MH-Flight-Simulator-X/PCB/Images/MicroHard.bmp

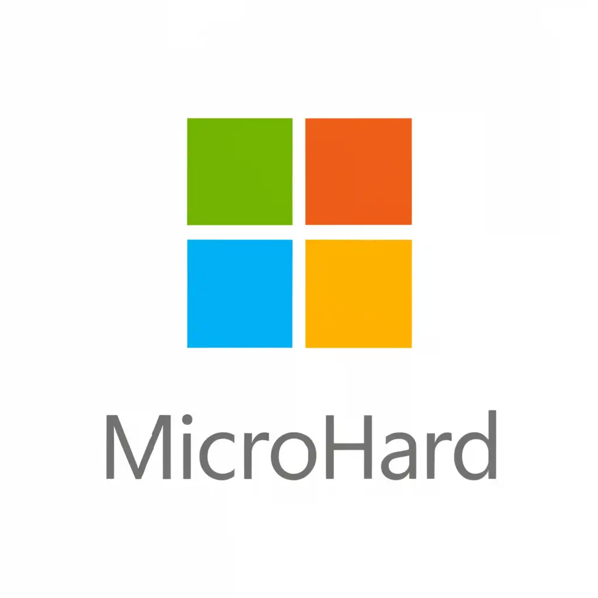
Images/MicroHard.bmp
