MH-Flight-Simulator-X/PCB/partsLib/CB3_3C_20M000000/CB3-3C-20M000000.step

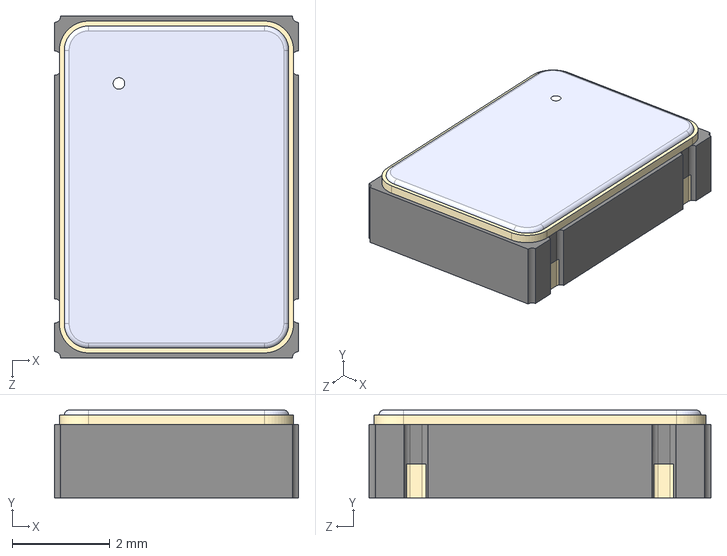
[picture p2: CAD file, 2024-09-24]
partsLib/CB3_3C_20M000000/CB3-3C-20M000000.step
5.00 x 1.80 x 7.00 mm
