MH-Flight-Simulator-X/PCB/partsLib/L77HDE15SD1CH4FVGA/L77HDE15SD1CH4FVGA.step

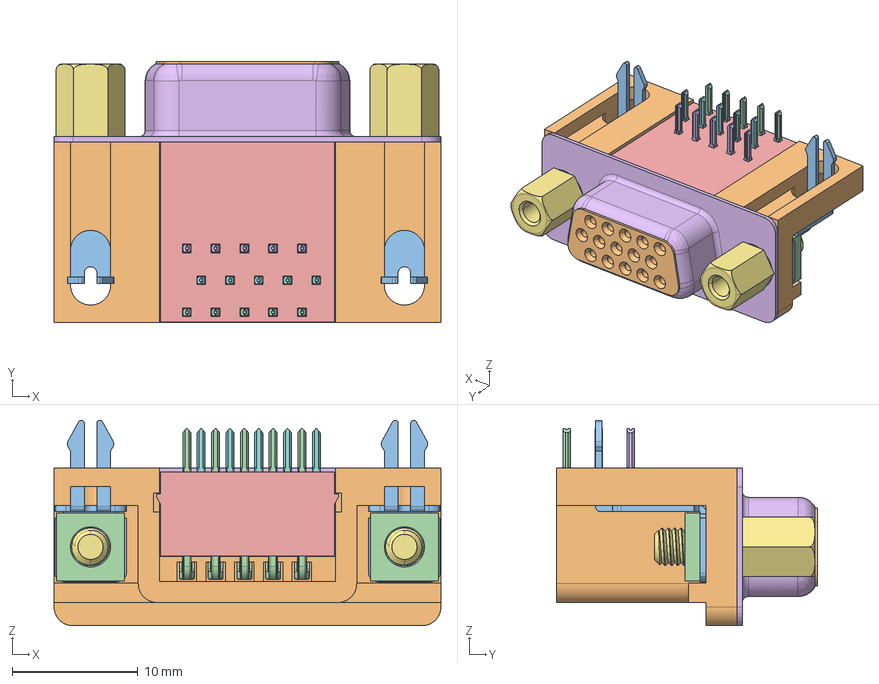
[picture p3: CAD file, 2024-09-26]
partsLib/L77HDE15SD1CH4FVGA/L77HDE15SD1CH4FVGA.step
30.8 x 20.8 x 16.4 mm
D112-H15S_79
ZZ_11 x 2
MM_3 x 2
MANIFOLD_SOLID_BREP_13339 x 5
MANIFOLD_SOLID_BREP_16179 x 5
MANIFOLD_SOLID_BREP_18054
MANIFOLD_SOLID_BREP_20824
MANIFOLD_SOLID_BREP_22635
MANIFOLD_SOLID_BREP_25405
MANIFOLD_SOLID_BREP_27216
MANIFOLD_SOLID_BREP_29986
MANIFOLD_SOLID_BREP_31797
MANIFOLD_SOLID_BREP_34567
MANIFOLD_SOLID_BREP_37337
MANIFOLD_SOLID_BREP_39100
MANIFOLD_SOLID_BREP_40938 x 5
MANIFOLD_SOLID_BREP_43779 x 5
CC_25
H15S-SHEL_1
MM-2_1 x 2
