MH-Flight-Simulator-X/PCB/partsLib/XC7A100T-2FTG256C/3D/XC7A100T-2FTG256C.stp

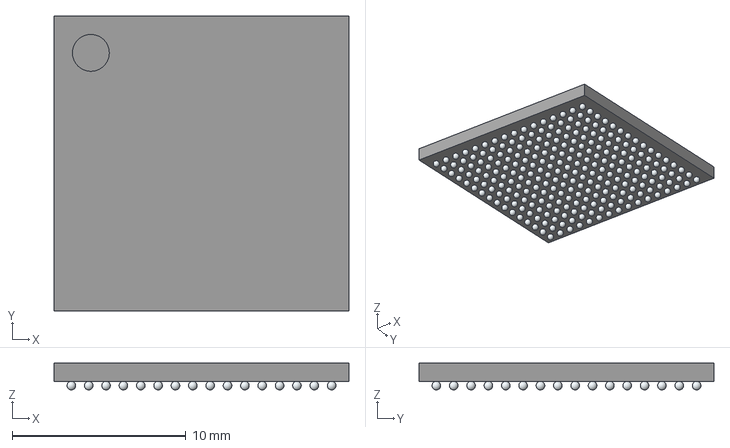
[picture p4: CAD file, 2024-09-26]
partsLib/XC7A100T-2FTG256C/3D/XC7A100T-2FTG256C.stp
17.0 x 17.0 x 1.55 mm
