MH-Flight-Simulator-X/PCB/partsLib/0878321420/87832-1420.step

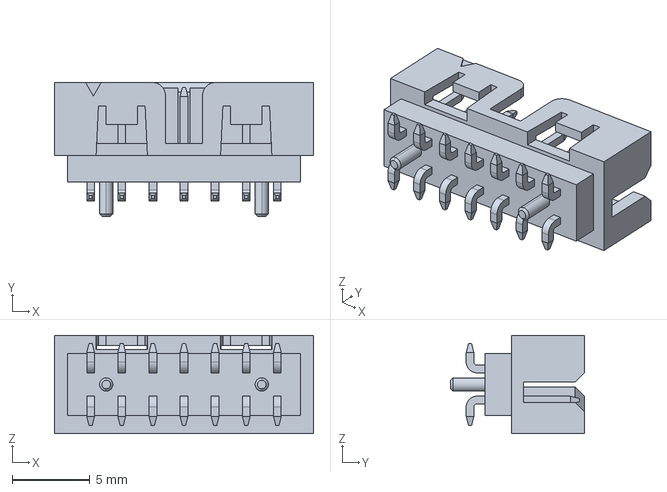
[picture p5: CAD file, 2024-09-26]
partsLib/0878321420/87832-1420.step
16.6 x 8.60 x 6.30 mm
