MH-Flight-Simulator-X/PCB/(list of files, cad)

Other CAD files:
MicroHardController/joystick_based.scad
MicroHardController/original.scad
partsLib/XC7A100T-2FTG256C/Allegro/bga256c100p16x16_1700x1700x155.psm
partsLib/XC7A100T-2FTG256C/DEHDL/xc7a100t_2ftg256c/chips/chips.prt
