MH-Flight-Simulator-X/PCB/(list of files, drawings)

Other design files:
partsLib/XC7A100T-2FTG256C/Altium/BGA256C100P16X16_1700X1700X155.PcbLib
partsLib/XC7A100T-2FTG256C/Altium/XC7A100T-2FTG256C.SchLib
