MH-Flight-Simulator-X/PCB/MicroHard/MicroHard.kicad_pcb

## KiCad design MicroHard/MicroHard.kicad_pcb (2024-11-20)

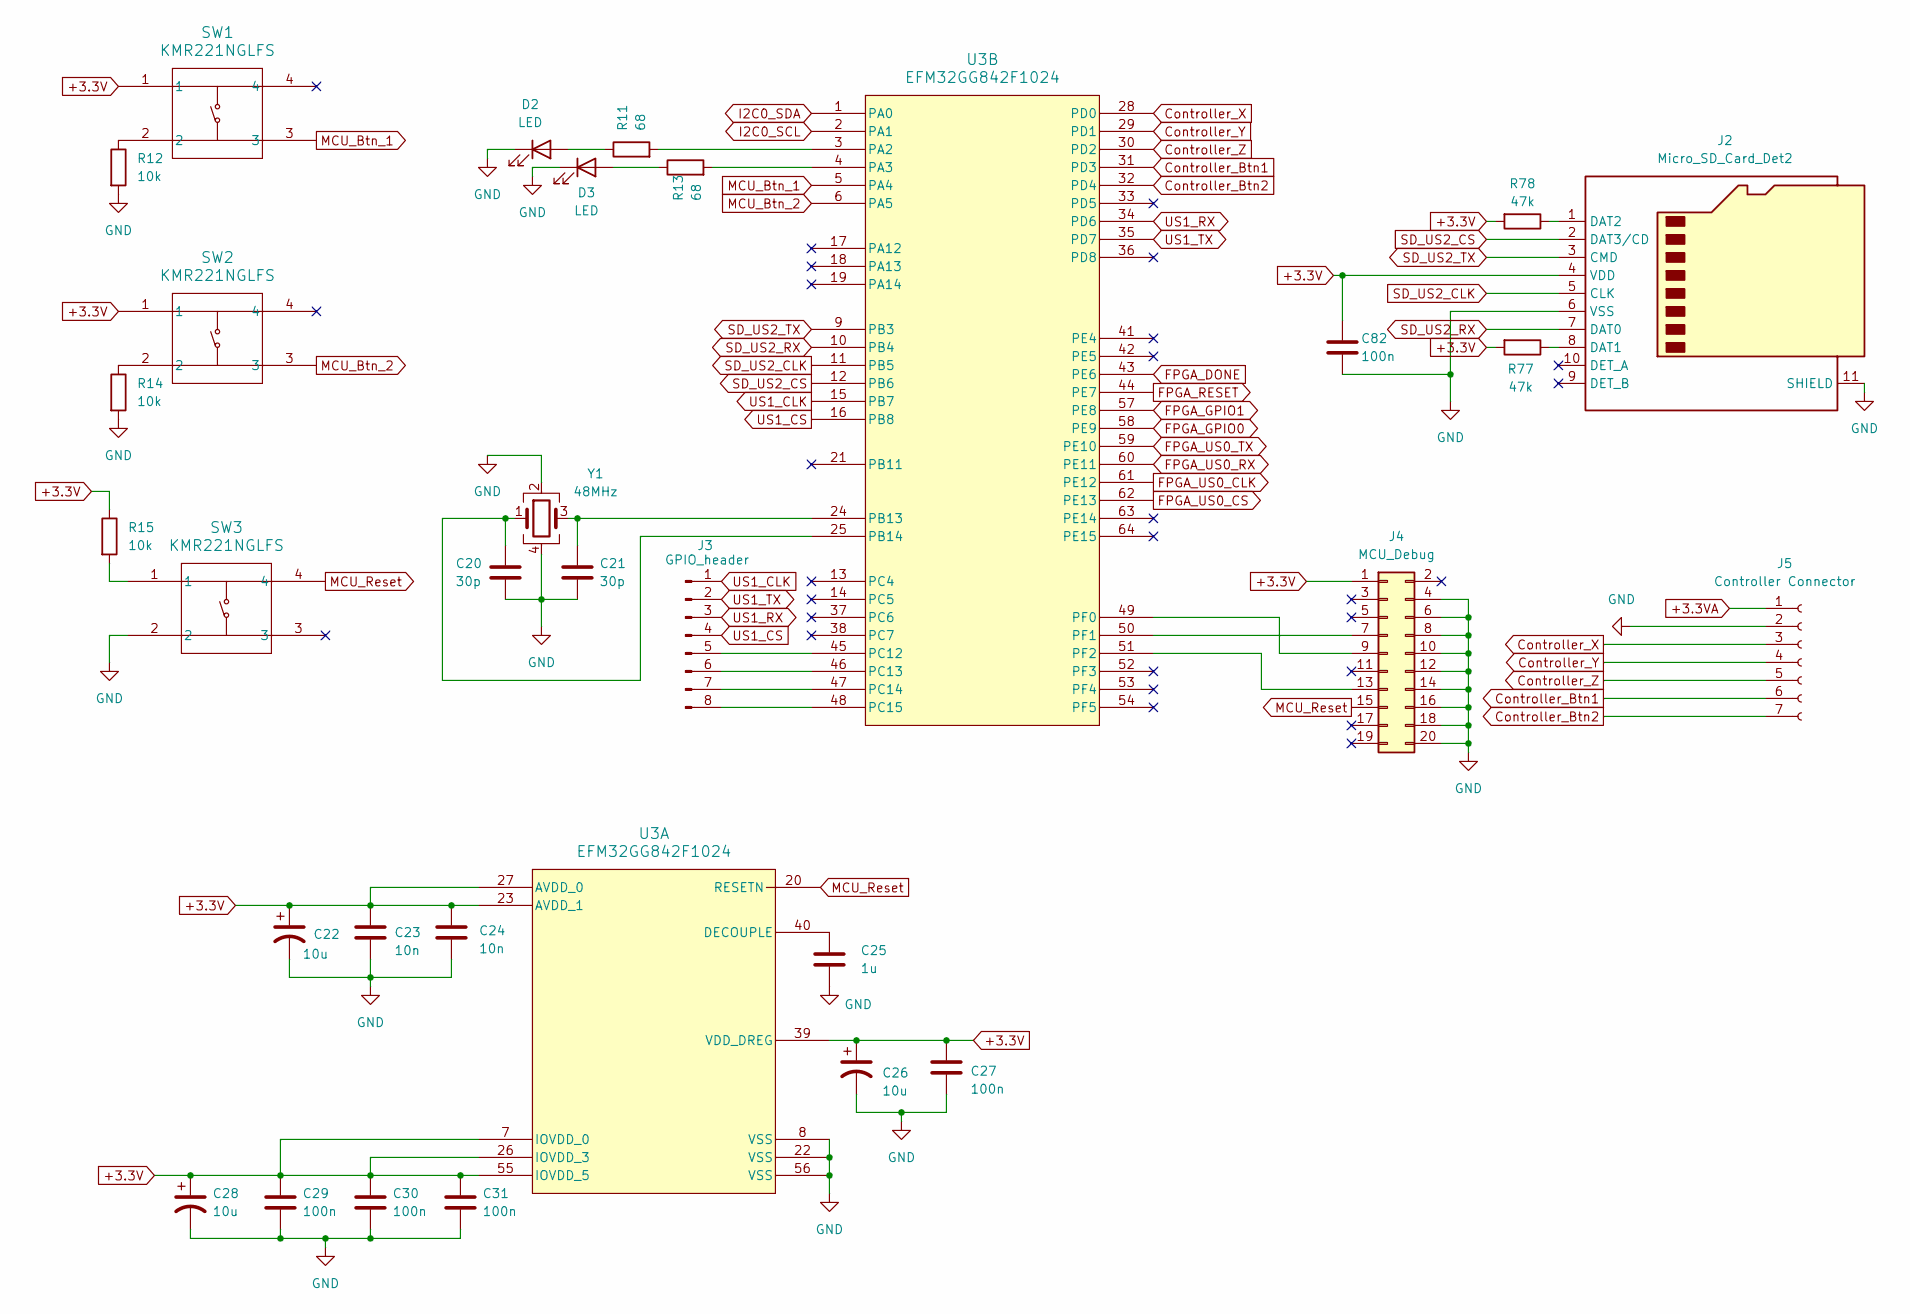
[picture p6: schematic mcu.kicad_sch, Microcontroller unit (MCU)]

Parts:
C20, C21: 30p; C_0805_2012Metric_Pad1.18x1.45mm_HandSolder
C22, C26, C28: 10u; C_1206_3216Metric_Pad1.33x1.80mm_HandSolder
C23, C24: 10n; C_1206_3216Metric_Pad1.33x1.80mm_HandSolder
C25: 1u; C_1206_3216Metric_Pad1.33x1.80mm_HandSolder
C27, C29, C30, C31, C82: 100n; C_1206_3216Metric_Pad1.33x1.80mm_HandSolder
D2, D3: LED; LED_1206_3216Metric_Pad1.42x1.75mm_HandSolder
J2: Micro_SD_Card_Det2; microSD_HC_Hirose_DM3AT-SF-PEJM5
J3: GPIO_header; PinHeader_1x08_P2.54mm_Vertical
J4: MCU_Debug; IDC-Header_2x10_P2.54mm_Vertical
J5: Controller Connector; PinHeader_1x07_P2.54mm_Vertical
R11, R13: 68; R_1206_3216Metric_Pad1.30x1.75mm_HandSolder
R12, R14, R15: 10k; R_1206_3216Metric_Pad1.30x1.75mm_HandSolder
R77, R78: 47k; R_1206_3216Metric_Pad1.30x1.75mm_HandSolder
SW1, SW2, SW3: KMR221NGLFS; KMR221_CNK
U3: EFM32GG842F1024; QFP64_10X10
Y1: 48MHz; Crystal_SMD_3225-4Pin_3.2x2.5mm_HandSoldering

Connections:
+3.3V: C22.1, C23.1, C24.1, C26.1, C27.1, C28.1, C29.1, C30.1, C31.1, C82.1, J2.4 (VDD), J4.1, R15.1, R77.2, R78.2, SW1.1, SW2.1, U3.7 (IOVDD_0), U3.23 (AVDD_1), U3.26 (IOVDD_3), U3.27 (AVDD_0), U3.39 (VDD_DREG), U3.55 (IOVDD_5); also elsewhere on the board
+3.3VA: J5.1; also elsewhere on the board
Controller_Btn1: J5.6, U3.31 (PD3)
Controller_Btn2: J5.7, U3.32 (PD4)
Controller_X: J5.3, U3.28 (PD0)
Controller_Y: J5.4, U3.29 (PD1)
Controller_Z: J5.5, U3.30 (PD2)
FPGA_DONE: U3.43 (PE6); also elsewhere on the board
FPGA_GPIO0: U3.58 (PE9); also elsewhere on the board
FPGA_GPIO1: U3.57 (PE8); also elsewhere on the board
FPGA_RESET: U3.44 (PE7); also elsewhere on the board
FPGA_US0_CLK: U3.61 (PE12); also elsewhere on the board
FPGA_US0_CS: U3.62 (PE13); also elsewhere on the board
FPGA_US0_RX: U3.60 (PE11); also elsewhere on the board
FPGA_US0_TX: U3.59 (PE10); also elsewhere on the board
GND: C20.2, C21.2, C22.2, C23.2, C24.2, C25.2, C26.2, C27.2, C28.2, C29.2, C30.2, C31.2, C82.2, D2.1 (K), D3.1 (K), J2.6 (VSS), J2.11 (SHIELD), J4.4, J4.6, J4.8, J4.10, J4.12, J4.14, J4.16, J4.18, J4.20, J5.2, R12.2, R14.2, SW3.2, U3.8 (VSS), U3.22 (VSS), U3.56 (VSS), Y1.2, Y1.4; also elsewhere on the board
I2C0_SCL: U3.2 (PA1); also elsewhere on the board
I2C0_SDA: U3.1 (PA0); also elsewhere on the board
MCU_Btn_1: SW1.3, U3.5 (PA4)
MCU_Btn_2: SW2.3, U3.6 (PA5)
MCU_Reset: J4.15, SW3.4, U3.20 (RESETN)
unnamed: D2.2 (A), R11.1
unnamed: D3.2 (A), R13.1
unnamed: J2.8 (DAT1), R77.1
unnamed: J2.1 (DAT2), R78.1
unnamed: J3.5, U3.45 (PC12)
unnamed: J3.6, U3.46 (PC13)
unnamed: J3.7, U3.47 (PC14)
unnamed: J3.8, U3.48 (PC15)
unnamed: J4.7, U3.50 (PF1)
unnamed: J4.9, U3.49 (PF0)
unnamed: J4.13, U3.51 (PF2)
unnamed: R12.1, SW1.2
unnamed: R14.1, SW2.2
unnamed: R15.2, SW3.1
unnamed: C25.1, U3.40 (DECOUPLE)
unnamed: R11.2, U3.3 (PA2)
unnamed: R13.2, U3.4 (PA3)
unnamed: C21.1, U3.24 (PB13), Y1.3
unnamed: C20.1, U3.25 (PB14), Y1.1
SD_US2_CLK: J2.5 (CLK), U3.11 (PB5)
SD_US2_CS: J2.2 (DAT3/CD), U3.12 (PB6)
SD_US2_RX: J2.7 (DAT0), U3.10 (PB4)
SD_US2_TX: J2.3 (CMD), U3.9 (PB3)
US1_CLK: J3.1, U3.15 (PB7)
US1_CS: J3.4, U3.16 (PB8)
US1_RX: J3.3, U3.34 (PD6)
US1_TX: J3.2, U3.35 (PD7)

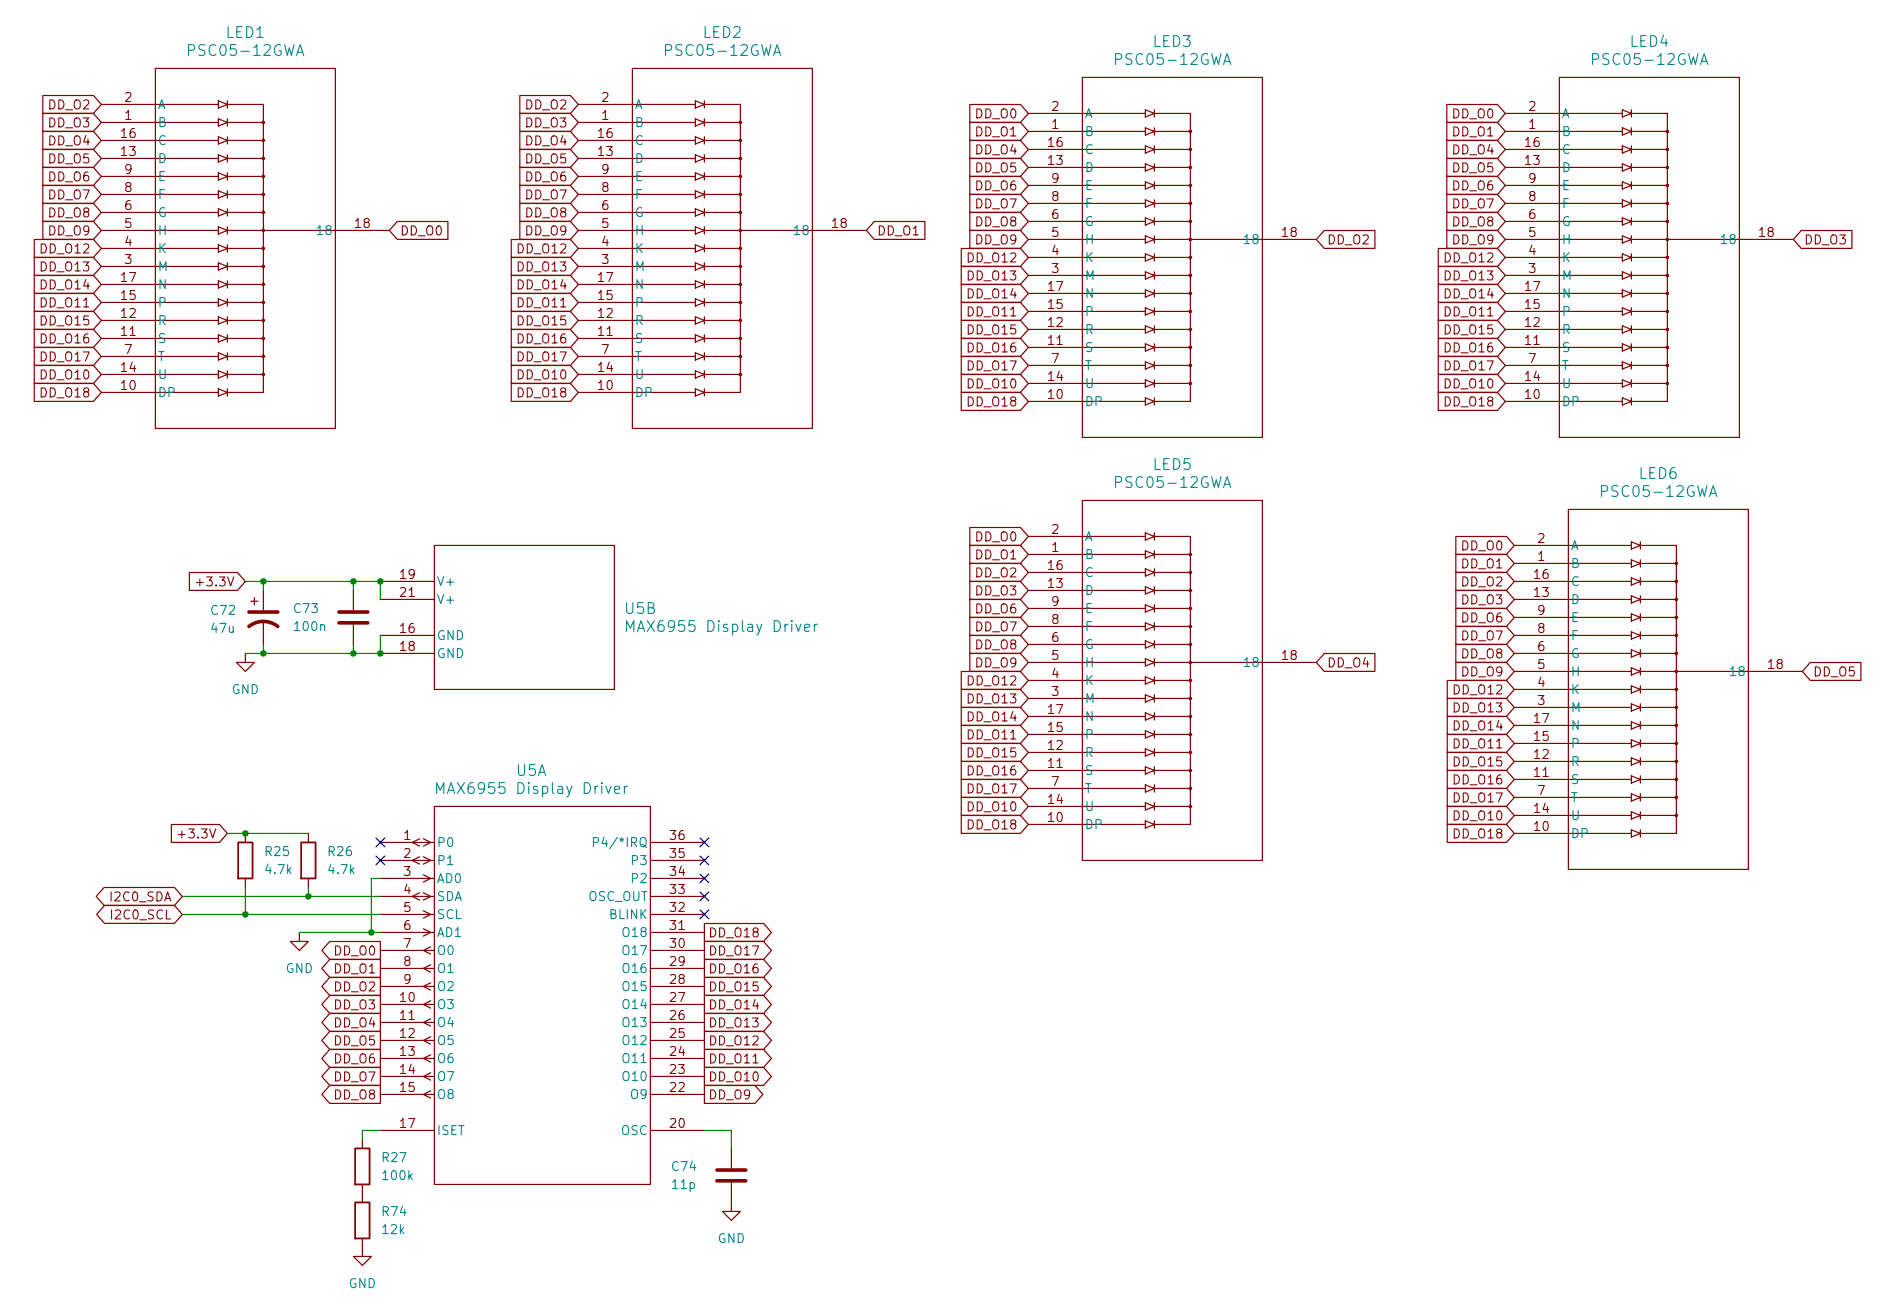
[picture p7: schematic display.kicad_sch, Alphanumeric Display]

Parts:
C72: 47u; C_1210_3225Metric_Pad1.33x2.70mm_HandSolder
C73: 100n; C_1206_3216Metric_Pad1.33x1.80mm_HandSolder
C74: 11p; C_0805_2012Metric_Pad1.18x1.45mm_HandSolder
LED1, LED2, LED3, LED4, LED5, LED6: PSC05-12GWA; PSC05-12GWA_LTO
R25, R26: 4.7k; R_1206_3216Metric_Pad1.30x1.75mm_HandSolder
R27: 100k; R_1206_3216Metric_Pad1.30x1.75mm_HandSolder
R74: 12k; R_1206_3216Metric_Pad1.30x1.75mm_HandSolder
U5: MAX6955 Display Driver; 21-0040_A36&plus_2_MXM

Connections:
+3.3V: C72.1, C73.1, R25.1, R26.1, U5.19 (V+), U5.21 (V+); also elsewhere on the board
DD_O0: LED1.18, LED3.2 (A), LED4.2 (A), LED5.2 (A), LED6.2 (A), U5.7 (O0)
DD_O1: LED2.18, LED3.1 (B), LED4.1 (B), LED5.1 (B), LED6.1 (B), U5.8 (O1)
DD_O2: LED1.2 (A), LED2.2 (A), LED3.18, LED5.16 (C), LED6.16 (C), U5.9 (O2)
DD_O3: LED1.1 (B), LED2.1 (B), LED4.18, LED5.13 (D), LED6.13 (D), U5.10 (O3)
DD_O4: LED1.16 (C), LED2.16 (C), LED3.16 (C), LED4.16 (C), LED5.18, U5.11 (O4)
DD_O5: LED1.13 (D), LED2.13 (D), LED3.13 (D), LED4.13 (D), LED6.18, U5.12 (O5)
DD_O6: LED1.9 (E), LED2.9 (E), LED3.9 (E), LED4.9 (E), LED5.9 (E), LED6.9 (E), U5.13 (O6)
DD_O7: LED1.8 (F), LED2.8 (F), LED3.8 (F), LED4.8 (F), LED5.8 (F), LED6.8 (F), U5.14 (O7)
DD_O8: LED1.6 (G), LED2.6 (G), LED3.6 (G), LED4.6 (G), LED5.6 (G), LED6.6 (G), U5.15 (O8)
DD_O9: LED1.5 (H), LED2.5 (H), LED3.5 (H), LED4.5 (H), LED5.5 (H), LED6.5 (H), U5.22 (O9)
DD_O10: LED1.14 (U), LED2.14 (U), LED3.14 (U), LED4.14 (U), LED5.14 (U), LED6.14 (U), U5.23 (O10)
DD_O11: LED1.15, LED2.15, LED3.15, LED4.15, LED5.15, LED6.15, U5.24 (O11)
DD_O12: LED1.4 (K), LED2.4 (K), LED3.4 (K), LED4.4 (K), LED5.4 (K), LED6.4 (K), U5.25 (O12)
DD_O13: LED1.3 (M), LED2.3 (M), LED3.3 (M), LED4.3 (M), LED5.3 (M), LED6.3 (M), U5.26 (O13)
DD_O14: LED1.17 (N), LED2.17 (N), LED3.17 (N), LED4.17 (N), LED5.17 (N), LED6.17 (N), U5.27 (O14)
DD_O15: LED1.12 (R), LED2.12 (R), LED3.12 (R), LED4.12 (R), LED5.12 (R), LED6.12 (R), U5.28 (O15)
DD_O16: LED1.11 (S), LED2.11 (S), LED3.11 (S), LED4.11 (S), LED5.11 (S), LED6.11 (S), U5.29 (O16)
DD_O17: LED1.7 (T), LED2.7 (T), LED3.7 (T), LED4.7 (T), LED5.7 (T), LED6.7 (T), U5.30 (O17)
DD_O18: LED1.10 (DP), LED2.10 (DP), LED3.10 (DP), LED4.10 (DP), LED5.10 (DP), LED6.10 (DP), U5.31 (O18)
GND: C72.2, C73.2, C74.2, R74.2, U5.3 (AD0), U5.6 (AD1), U5.16 (GND), U5.18 (GND); also elsewhere on the board
I2C0_SCL: R25.2, U5.5 (SCL); also elsewhere on the board
I2C0_SDA: R26.2, U5.4 (SDA); also elsewhere on the board
unnamed: R27.2, R74.1
unnamed: R27.1, U5.17 (ISET)
unnamed: C74.1, U5.20 (OSC)

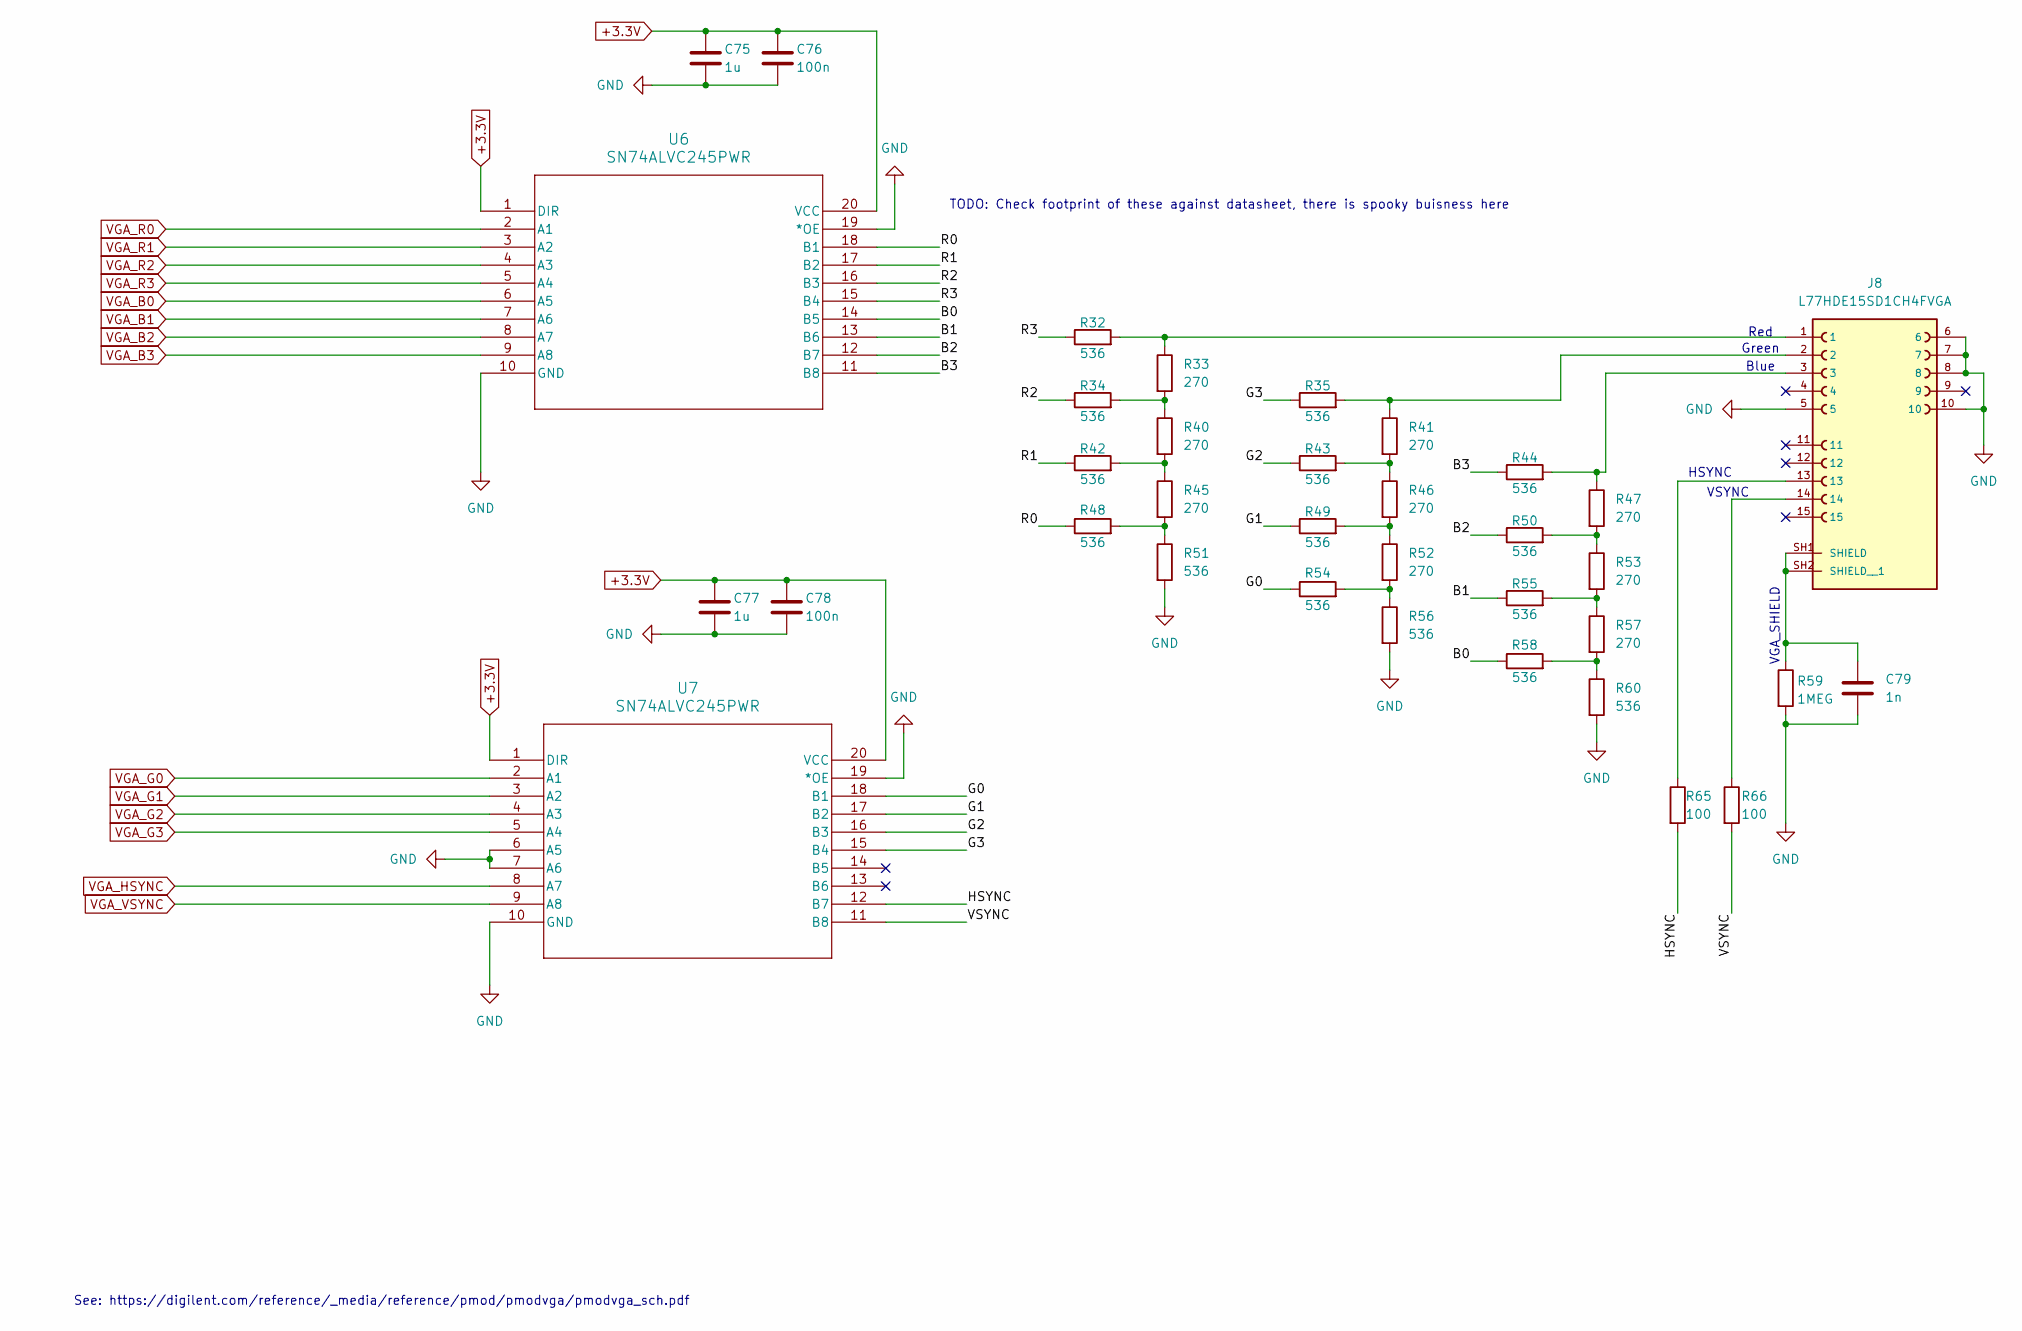
[picture p8: schematic vga_out_sch.kicad_sch, VGA]

Parts:
C75, C77: 1u; C_1206_3216Metric_Pad1.33x1.80mm_HandSolder
C76, C78: 100n; C_1206_3216Metric_Pad1.33x1.80mm_HandSolder
C79: 1n; C_0805_2012Metric_Pad1.18x1.45mm_HandSolder
J8: L77HDE15SD1CH4FVGA; AMPHENOL_L77HDE15SD1CH4FVGA; PARTREV 1
R32, R34, R35, R42, R43, R44, R48, R49, R50, R51, R54, R55, R56, R58, R60: 536; R_1206_3216Metric_Pad1.30x1.75mm_HandSolder
R33, R40, R41, R45, R46, R47, R52, R53, R57: 270; R_1206_3216Metric_Pad1.30x1.75mm_HandSolder
R59: 1MEG; R_1206_3216Metric_Pad1.30x1.75mm_HandSolder
R65, R66: 100; R_1206_3216Metric_Pad1.30x1.75mm_HandSolder
U6, U7: SN74ALVC245PWR; PW20

Connections:
+3.3V: C75.1, C76.1, C77.1, C78.1, U6.1 (DIR), U6.20 (VCC), U7.1 (DIR), U7.20 (VCC); also elsewhere on the board
/VGA out/B0: R58.1, U6.14 (B5)
/VGA out/B1: R55.1, U6.13 (B6)
/VGA out/B2: R50.1, U6.12 (B7)
/VGA out/B3: R44.1, U6.11 (B8)
/VGA out/G0: R54.1, U7.18 (B1)
/VGA out/G1: R49.1, U7.17 (B2)
/VGA out/G2: R43.1, U7.16 (B3)
/VGA out/G3: R35.1, U7.15 (B4)
/VGA out/HSYNC: R65.2, U7.12 (B7)
/VGA out/R0: R48.1, U6.18 (B1)
/VGA out/R1: R42.1, U6.17 (B2)
/VGA out/R2: R34.1, U6.16 (B3)
/VGA out/R3: R32.1, U6.15 (B4)
/VGA out/VSYNC: R66.2, U7.11 (B8)
GND: C75.2, C76.2, C77.2, C78.2, C79.2, J8.5, J8.6, J8.7, J8.8, J8.10, R51.2, R56.2, R59.2, R60.2, U6.10 (GND), U6.19 (*OE), U7.6 (A5), U7.7 (A6), U7.10 (GND), U7.19 (*OE); also elsewhere on the board
unnamed: J8.1, R32.2, R33.1
unnamed: J8.2, R35.2, R41.1
unnamed: J8.3, R44.2, R47.1
unnamed: J8.13, R65.1
unnamed: J8.14, R66.1
unnamed: C79.1, J8.SH1 (SHIELD), J8.SH2 (SHIELD__1), R59.1
unnamed: R33.2, R34.2, R40.1
unnamed: R40.2, R42.2, R45.1
unnamed: R41.2, R43.2, R46.1
unnamed: R45.2, R48.2, R51.1
unnamed: R46.2, R49.2, R52.1
unnamed: R47.2, R50.2, R53.1
unnamed: R52.2, R54.2, R56.1
unnamed: R53.2, R55.2, R57.1
unnamed: R57.2, R58.2, R60.1
VGA_B0: U6.6 (A5); also elsewhere on the board
VGA_B1: U6.7 (A6); also elsewhere on the board
VGA_B2: U6.8 (A7); also elsewhere on the board
VGA_B3: U6.9 (A8); also elsewhere on the board
VGA_G0: U7.2 (A1); also elsewhere on the board
VGA_G1: U7.3 (A2); also elsewhere on the board
VGA_G2: U7.4 (A3); also elsewhere on the board
VGA_G3: U7.5 (A4); also elsewhere on the board
VGA_HSYNC: U7.8 (A7); also elsewhere on the board
VGA_R0: U6.2 (A1); also elsewhere on the board
VGA_R1: U6.3 (A2); also elsewhere on the board
VGA_R2: U6.4 (A3); also elsewhere on the board
VGA_R3: U6.5 (A4); also elsewhere on the board
VGA_VSYNC: U7.9 (A8); also elsewhere on the board

Notes on the sheet:
HSYNC
Blue
VGA_SHIELD
Green
See: https://digilent.com/reference/_media/reference/pmod/pmodvga/pmodvga_sch.pdf
TODO: Check footprint of these against datasheet, there is spooky buisness here
Red
VSYNC

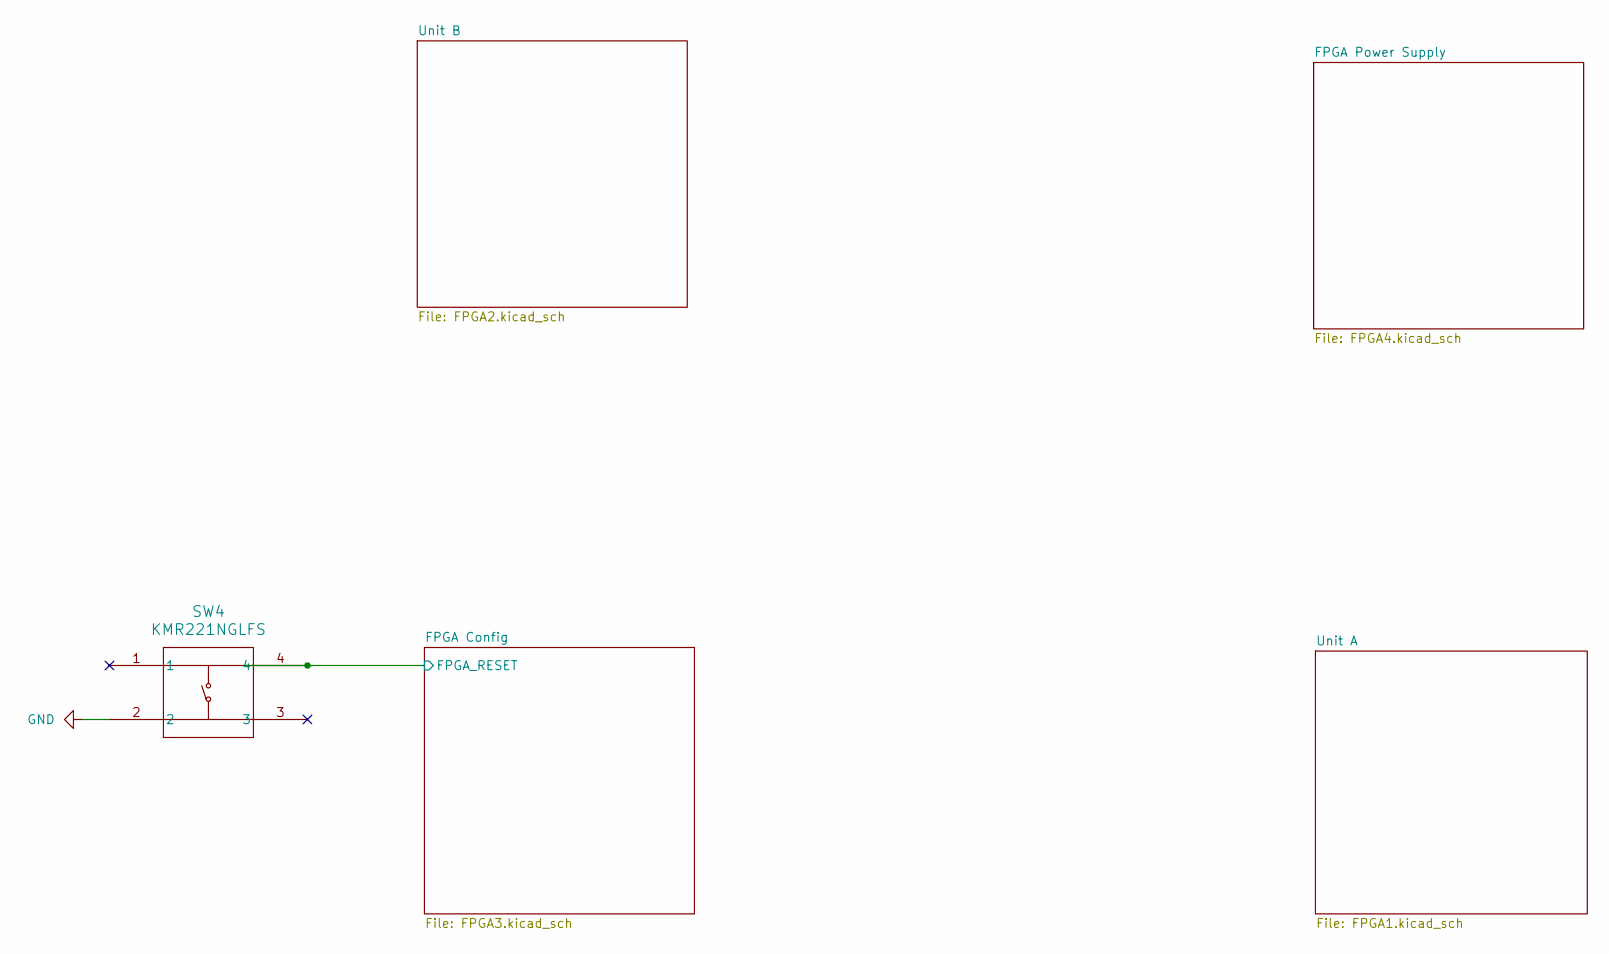
[picture p9: schematic FPGA.kicad_sch]

Parts:
SW4: KMR221NGLFS; KMR221_CNK

Connections:
FPGA_RESET: SW4.4; also elsewhere on the board
GND: SW4.2; also elsewhere on the board

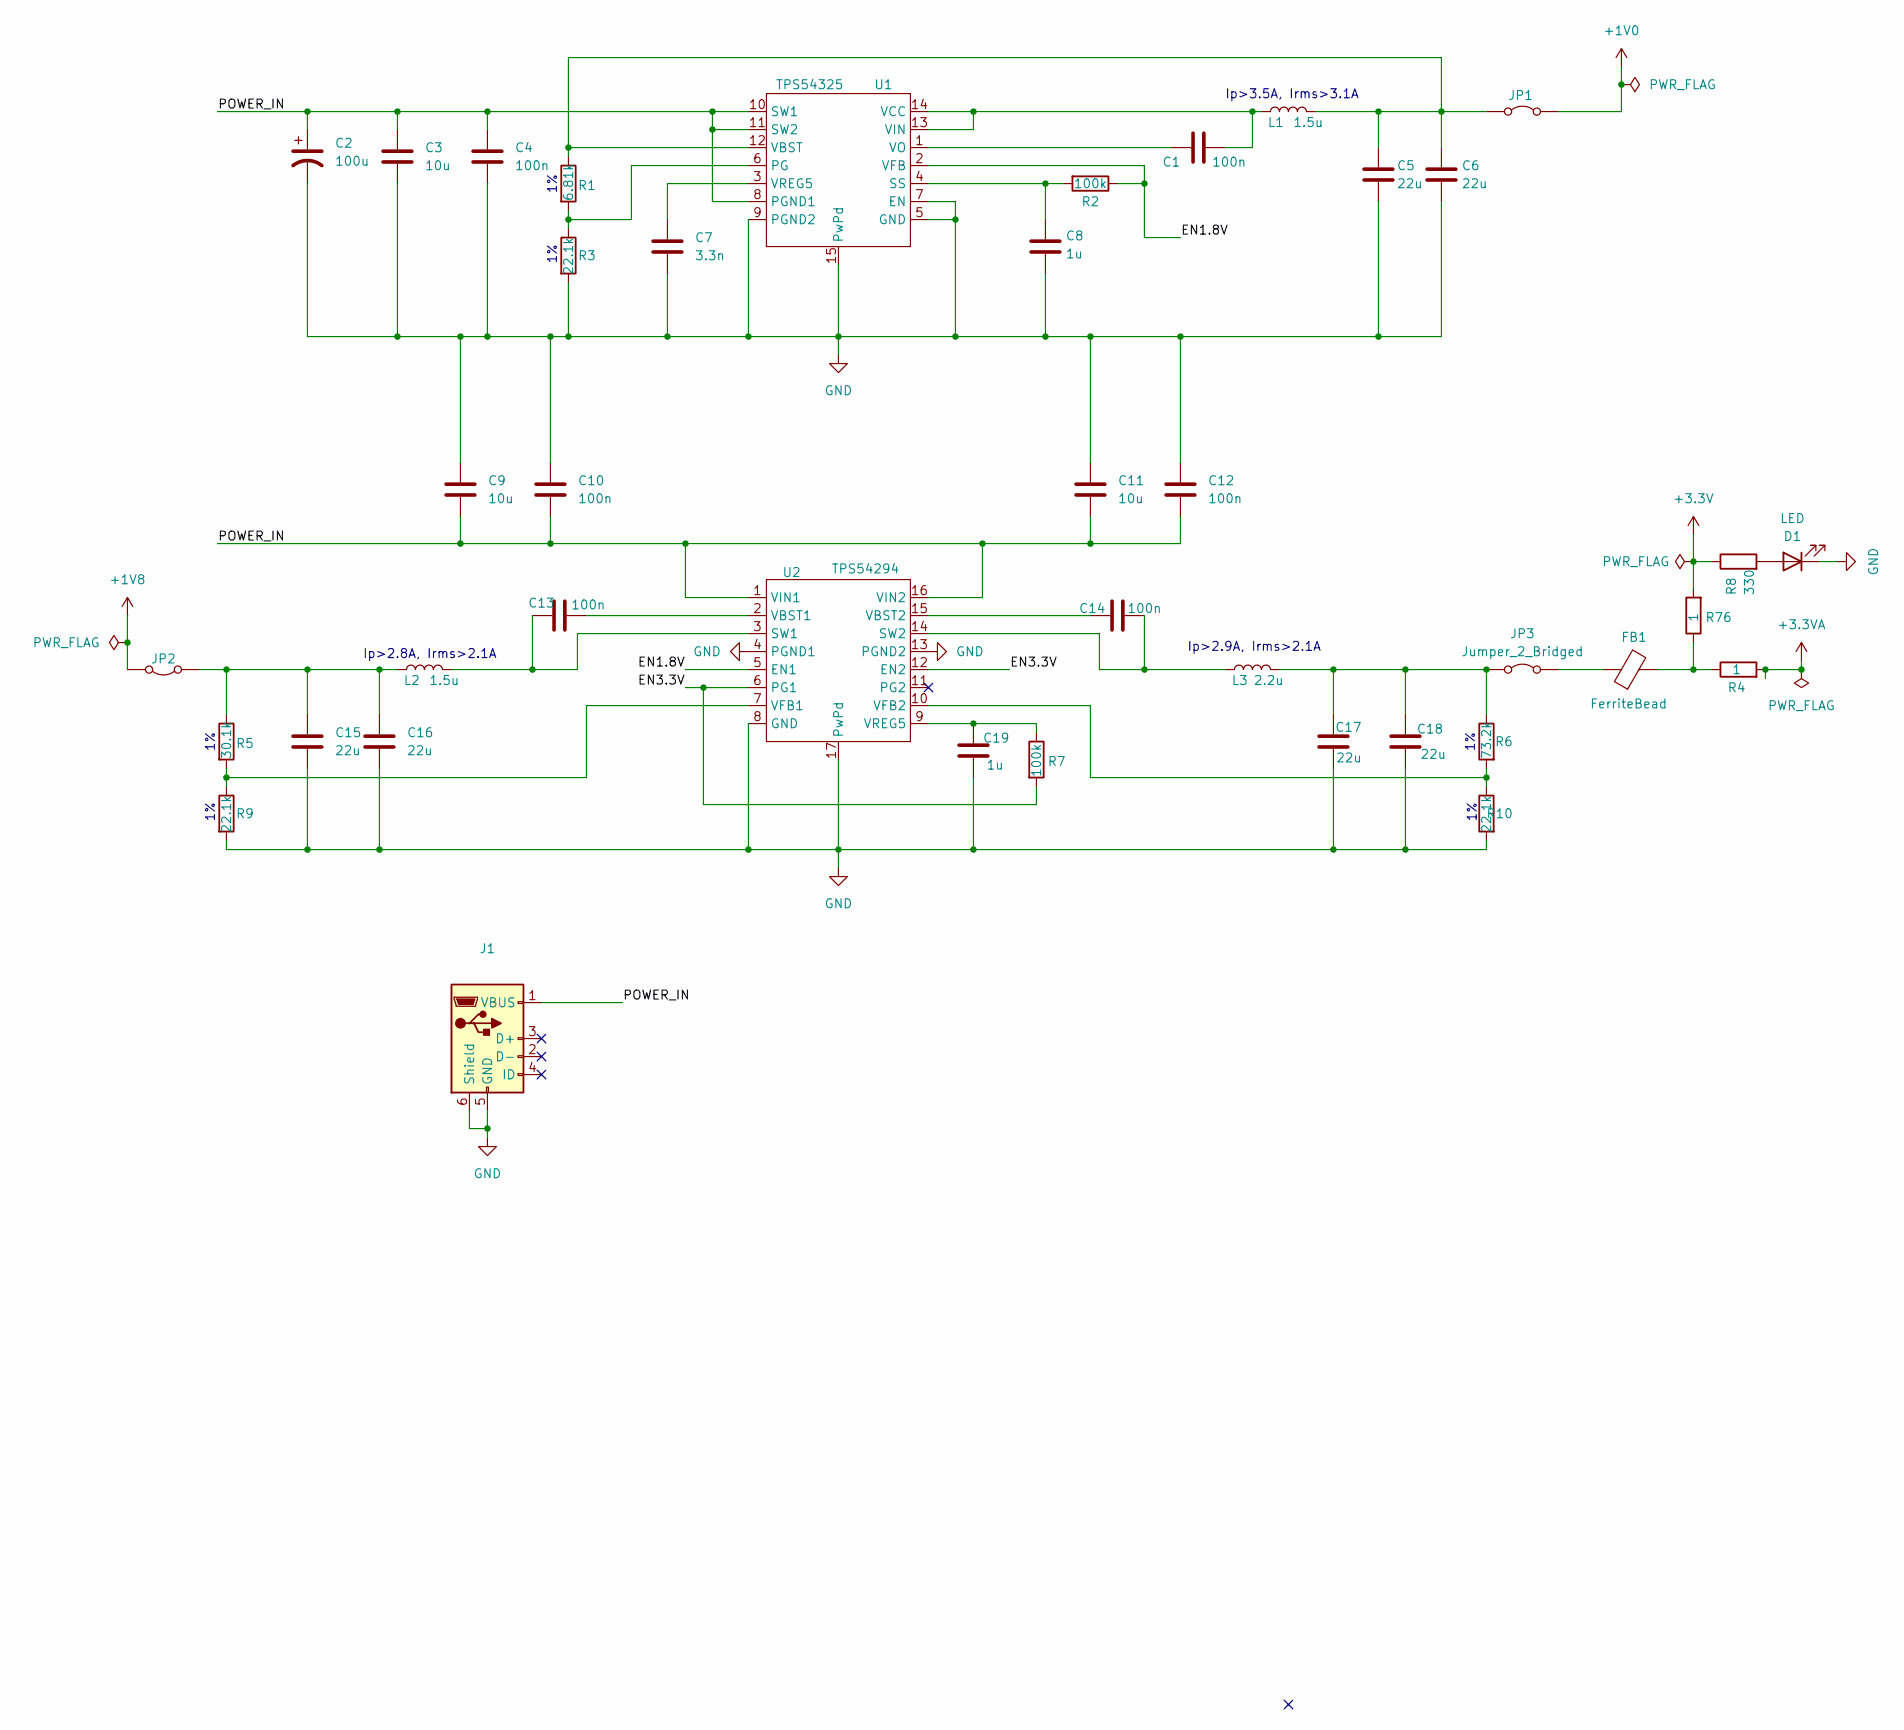
[picture p10: schematic PowerSupply.kicad_sch, Power Supply]

Parts:
C1, C4, C10, C12, C13, C14: 100n; C_1206_3216Metric_Pad1.33x1.80mm_HandSolder
C2: 100u; C_1210_3225Metric_Pad1.33x2.70mm_HandSolder
C3, C9, C11: 10u; C_1206_3216Metric_Pad1.33x1.80mm_HandSolder
C5, C6, C15, C16, C17, C18: 22u; C_1206_3216Metric_Pad1.33x1.80mm_HandSolder
C7: 3.3n; C_1206_3216Metric_Pad1.33x1.80mm_HandSolder
C8, C19: 1u; C_1206_3216Metric_Pad1.33x1.80mm_HandSolder
D1: LED; LED_1206_3216Metric_Pad1.42x1.75mm_HandSolder
FB1: FerriteBead; R_1206_3216Metric_Pad1.30x1.75mm_HandSolder
J1: USB_B_Micro; USB_Micro-B_Amphenol_10118194_Horizontal
JP1, JP2, JP3: Jumper_2_Bridged; PinHeader_1x02_P2.54mm_Vertical
L1, L2: 1.5u; IND_8357022_WRE
L3: 2.2u; IND_8357022_WRE
R1: 6.81k; R_1206_3216Metric_Pad1.30x1.75mm_HandSolder
R2, R7: 100k; R_1206_3216Metric_Pad1.30x1.75mm_HandSolder
R3, R9, R10: 22.1k; R_1206_3216Metric_Pad1.30x1.75mm_HandSolder
R4, R76: 1; R_1206_3216Metric_Pad1.30x1.75mm_HandSolder
R5: 30.1k; R_1206_3216Metric_Pad1.30x1.75mm_HandSolder
R6: 73.2k; R_1206_3216Metric_Pad1.30x1.75mm_HandSolder
R8: 330; R_1206_3216Metric_Pad1.30x1.75mm_HandSolder
U1: TPS54325; PWP14_2P31X2P46
U2: TPS54294; PWP16_2P31X2P46

Connections:
+1V0: JP1.2 (B); also elsewhere on the board
+1V8: JP2.2 (B); also elsewhere on the board
+3.3V: R8.1, R76.2; also elsewhere on the board
+3.3VA: R4.2; also elsewhere on the board
/Power Supply/EN1.8V: R2.1, U1.2 (VFB), U2.5 (EN1)
/Power Supply/EN3.3V: R7.2, U2.6 (PG1), U2.12 (EN2)
/Power Supply/POWER_IN: C2.1, C3.1, C4.1, C9.2, C10.2, C11.2, C12.2, J1.1 (VBUS), U1.8 (PGND1), U1.10 (SW1), U1.11 (SW2), U2.1 (VIN1), U2.16 (VIN2)
GND: C2.2, C3.2, C4.2, C5.2, C6.2, C7.2, C8.2, C9.1, C10.1, C11.1, C12.1, C15.2, C16.2, C17.2, C18.2, C19.2, D1.1 (K), J1.5 (GND), J1.6 (Shield), R3.2, R9.2, R10.2, U1.5 (GND), U1.7 (EN), U1.9 (PGND2), U1.15 (PwPd), U2.4 (PGND1), U2.8 (GND), U2.13 (PGND2), U2.17 (PwPd), U2.V; also elsewhere on the board
unnamed: D1.2 (A), R8.2
unnamed: FB1.2, R4.1, R76.1
unnamed: C5.1, C6.1, JP1.1 (A), L1.2, R1.1, U1.12 (VBST)
unnamed: C15.1, C16.1, JP2.1 (A), L2.1, R5.1
unnamed: C17.1, C18.1, JP3.1 (A), L3.1, R6.1
unnamed: FB1.1, JP3.2 (B)
unnamed: R1.2, R3.1, U1.6 (PG)
unnamed: C8.1, R2.2, U1.4 (SS)
unnamed: C1.1, L1.1, U1.13 (VIN), U1.14 (VCC)
unnamed: C1.2, U1.1 (VO)
unnamed: C7.1, U1.3 (VREG5)
unnamed: C13.1, L2.2, U2.3 (SW1)
unnamed: C14.1, L3.2, U2.14 (SW2)
unnamed: C13.2, U2.2 (VBST1)
unnamed: C14.2, U2.15 (VBST2)
unnamed: R5.2, R9.1, U2.7 (VFB1)
unnamed: R6.2, R10.1, U2.10 (VFB2)
unnamed: C19.1, R7.1, U2.9 (VREG5)

Notes on the sheet:
Ip>2.9A, Irms>2.1A
Ip>3.5A, Irms>3.1A
Ip>2.8A, Irms>2.1A
