MH-Flight-Simulator-X/PCB/MicroHard/MicroHard.kicad_pcb

## KiCad design MicroHard/MicroHard.kicad_pcb (continued)

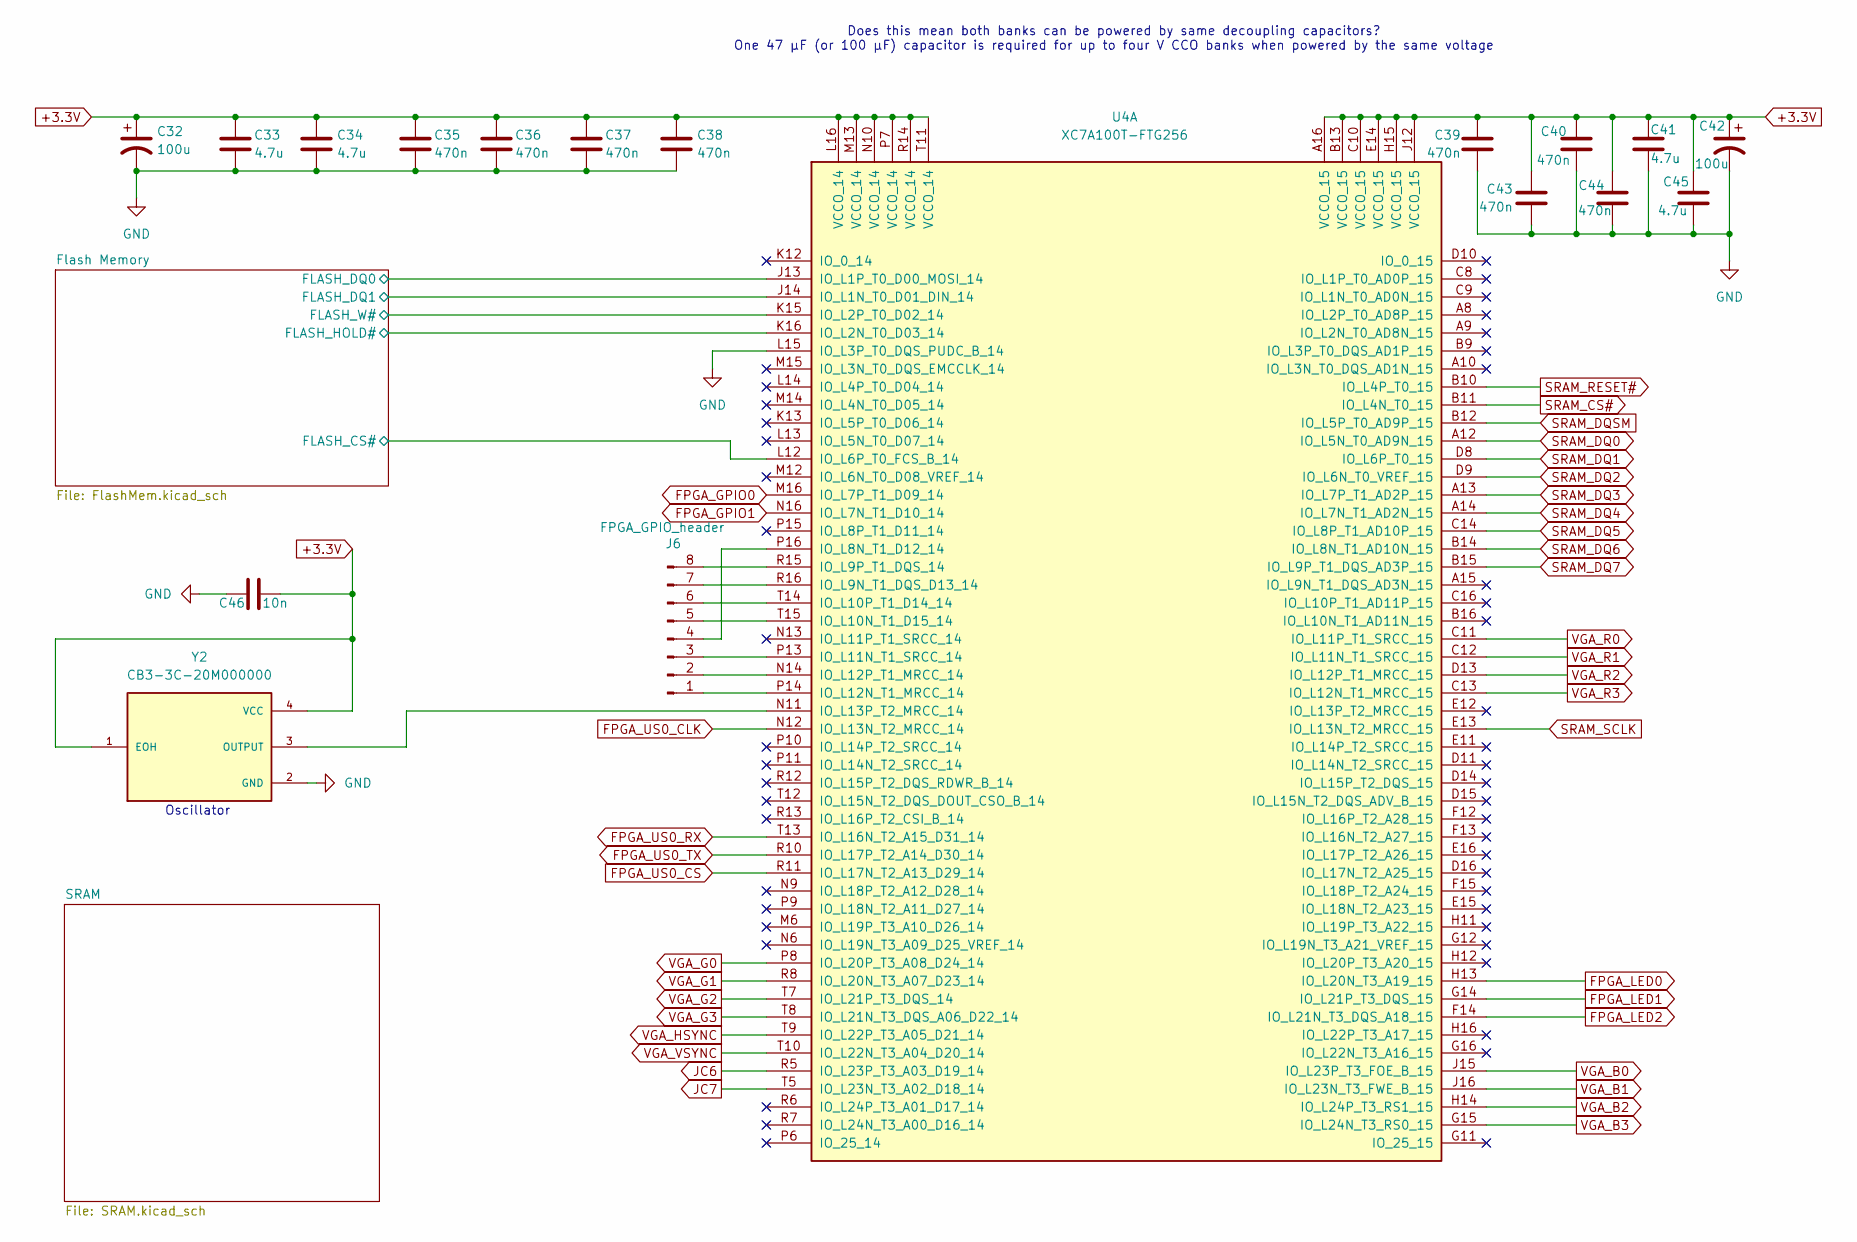
[picture p11: schematic FPGA1.kicad_sch, FPGA Unit A]

Parts:
C32, C42: 100u; C_1210_3225Metric_Pad1.33x2.70mm_HandSolder
C33, C34, C41, C45: 4.7u; C_0805_2012Metric_Pad1.18x1.45mm_HandSolder
C35, C36, C37, C38, C39, C40, C43, C44: 470n; C_0603_1608Metric_Pad1.08x0.95mm_HandSolder
C46: 10n; C_1206_3216Metric_Pad1.33x1.80mm_HandSolder
J6: FPGA_GPIO_header; PinHeader_1x08_P2.54mm_Vertical
U4: XC7A100T-FTG256; BGA256C100P16X16_1700X1700X155
Y2: CB3-3C-20M000000; OSC_CB3-3C-20M000000; PARTREV NA

Connections:
+3.3V: C32.1, C33.1, C34.1, C35.1, C36.1, C37.1, C38.1, C39.1, C40.1, C41.1, C42.1, C43.1, C44.1, C45.1, C46.1, U4.A16 (VCCO_15), U4.B13 (VCCO_15), U4.C10 (VCCO_15), U4.E14 (VCCO_15), U4.H15 (VCCO_15), U4.J12 (VCCO_15), U4.L16 (VCCO_14), U4.M13 (VCCO_14), U4.N10 (VCCO_14), U4.P7 (VCCO_14), U4.R14 (VCCO_14), U4.T11 (VCCO_14), Y2.1 (EOH), Y2.4 (VCC); also elsewhere on the board
/FPGA/Unit A/Flash Memory/FLASH_CS#: U4.L12 (IO_L6P_T0_FCS_B_14); also elsewhere on the board
/FPGA/Unit A/Flash Memory/FLASH_DQ0: U4.J13 (IO_L1P_T0_D00_MOSI_14); also elsewhere on the board
/FPGA/Unit A/Flash Memory/FLASH_DQ1: U4.J14 (IO_L1N_T0_D01_DIN_14); also elsewhere on the board
/FPGA/Unit A/Flash Memory/FLASH_HOLD#: U4.K16 (IO_L2N_T0_D03_14); also elsewhere on the board
/FPGA/Unit A/Flash Memory/FLASH_W#: U4.K15 (IO_L2P_T0_D02_14); also elsewhere on the board
FPGA_GPIO0: U4.M16 (IO_L7P_T1_D09_14); also elsewhere on the board
FPGA_GPIO1: U4.N16 (IO_L7N_T1_D10_14); also elsewhere on the board
FPGA_LED0: U4.H13 (IO_L20N_T3_A19_15); also elsewhere on the board
FPGA_LED1: U4.G14 (IO_L21P_T3_DQS_15); also elsewhere on the board
FPGA_LED2: U4.F14 (IO_L21N_T3_DQS_A18_15); also elsewhere on the board
FPGA_US0_CLK: U4.N12 (IO_L13N_T2_MRCC_14); also elsewhere on the board
FPGA_US0_CS: U4.R11 (IO_L17N_T2_A13_D29_14); also elsewhere on the board
FPGA_US0_RX: U4.T13 (IO_L16N_T2_A15_D31_14); also elsewhere on the board
FPGA_US0_TX: U4.R10 (IO_L17P_T2_A14_D30_14); also elsewhere on the board
GND: C32.2, C33.2, C34.2, C35.2, C36.2, C37.2, C38.2, C39.2, C40.2, C41.2, C42.2, C43.2, C44.2, C45.2, C46.2, U4.L15 (IO_L3P_T0_DQS_PUDC_B_14), Y2.2 (GND); also elsewhere on the board
JC6: U4.R5 (IO_L23P_T3_A03_D19_14)
JC7: U4.T5 (IO_L23N_T3_A02_D18_14)
unnamed: J6.1, U4.P14 (IO_L12N_T1_MRCC_14)
unnamed: J6.2, U4.N14 (IO_L12P_T1_MRCC_14)
unnamed: J6.3, U4.P13 (IO_L11N_T1_SRCC_14)
unnamed: J6.4, U4.P16 (IO_L8N_T1_D12_14)
unnamed: J6.5, U4.T15 (IO_L10N_T1_D15_14)
unnamed: J6.6, U4.T14 (IO_L10P_T1_D14_14)
unnamed: J6.7, U4.R16 (IO_L9N_T1_DQS_D13_14)
unnamed: J6.8, U4.R15 (IO_L9P_T1_DQS_14)
unnamed: U4.N11 (IO_L13P_T2_MRCC_14), Y2.3 (OUTPUT)
SRAM_CS#: U4.B11 (IO_L4N_T0_15); also elsewhere on the board
SRAM_DQ0: U4.A12 (IO_L5N_T0_AD9N_15); also elsewhere on the board
SRAM_DQ1: U4.D8 (IO_L6P_T0_15); also elsewhere on the board
SRAM_DQ2: U4.D9 (IO_L6N_T0_VREF_15); also elsewhere on the board
SRAM_DQ3: U4.A13 (IO_L7P_T1_AD2P_15); also elsewhere on the board
SRAM_DQ4: U4.A14 (IO_L7N_T1_AD2N_15); also elsewhere on the board
SRAM_DQ5: U4.C14 (IO_L8P_T1_AD10P_15); also elsewhere on the board
SRAM_DQ6: U4.B14 (IO_L8N_T1_AD10N_15); also elsewhere on the board
SRAM_DQ7: U4.B15 (IO_L9P_T1_DQS_AD3P_15); also elsewhere on the board
SRAM_DQSM: U4.B12 (IO_L5P_T0_AD9P_15); also elsewhere on the board
SRAM_RESET#: U4.B10 (IO_L4P_T0_15); also elsewhere on the board
SRAM_SCLK: U4.E13 (IO_L13N_T2_MRCC_15); also elsewhere on the board
VGA_B0: U4.J15 (IO_L23P_T3_FOE_B_15); also elsewhere on the board
VGA_B1: U4.J16 (IO_L23N_T3_FWE_B_15); also elsewhere on the board
VGA_B2: U4.H14 (IO_L24P_T3_RS1_15); also elsewhere on the board
VGA_B3: U4.G15 (IO_L24N_T3_RS0_15); also elsewhere on the board
VGA_G0: U4.P8 (IO_L20P_T3_A08_D24_14); also elsewhere on the board
VGA_G1: U4.R8 (IO_L20N_T3_A07_D23_14); also elsewhere on the board
VGA_G2: U4.T7 (IO_L21P_T3_DQS_14); also elsewhere on the board
VGA_G3: U4.T8 (IO_L21N_T3_DQS_A06_D22_14); also elsewhere on the board
VGA_HSYNC: U4.T9 (IO_L22P_T3_A05_D21_14); also elsewhere on the board
VGA_R0: U4.C11 (IO_L11P_T1_SRCC_15); also elsewhere on the board
VGA_R1: U4.C12 (IO_L11N_T1_SRCC_15); also elsewhere on the board
VGA_R2: U4.D13 (IO_L12P_T1_MRCC_15); also elsewhere on the board
VGA_R3: U4.C13 (IO_L12N_T1_MRCC_15); also elsewhere on the board
VGA_VSYNC: U4.T10 (IO_L22N_T3_A04_D20_14); also elsewhere on the board

Notes on the sheet:
Does this mean both banks can be powered by same decoupling capacitors? One 47 μF (or 100 μF) capacitor is required for up to four V CCO banks when powered by the same voltage
Oscillator

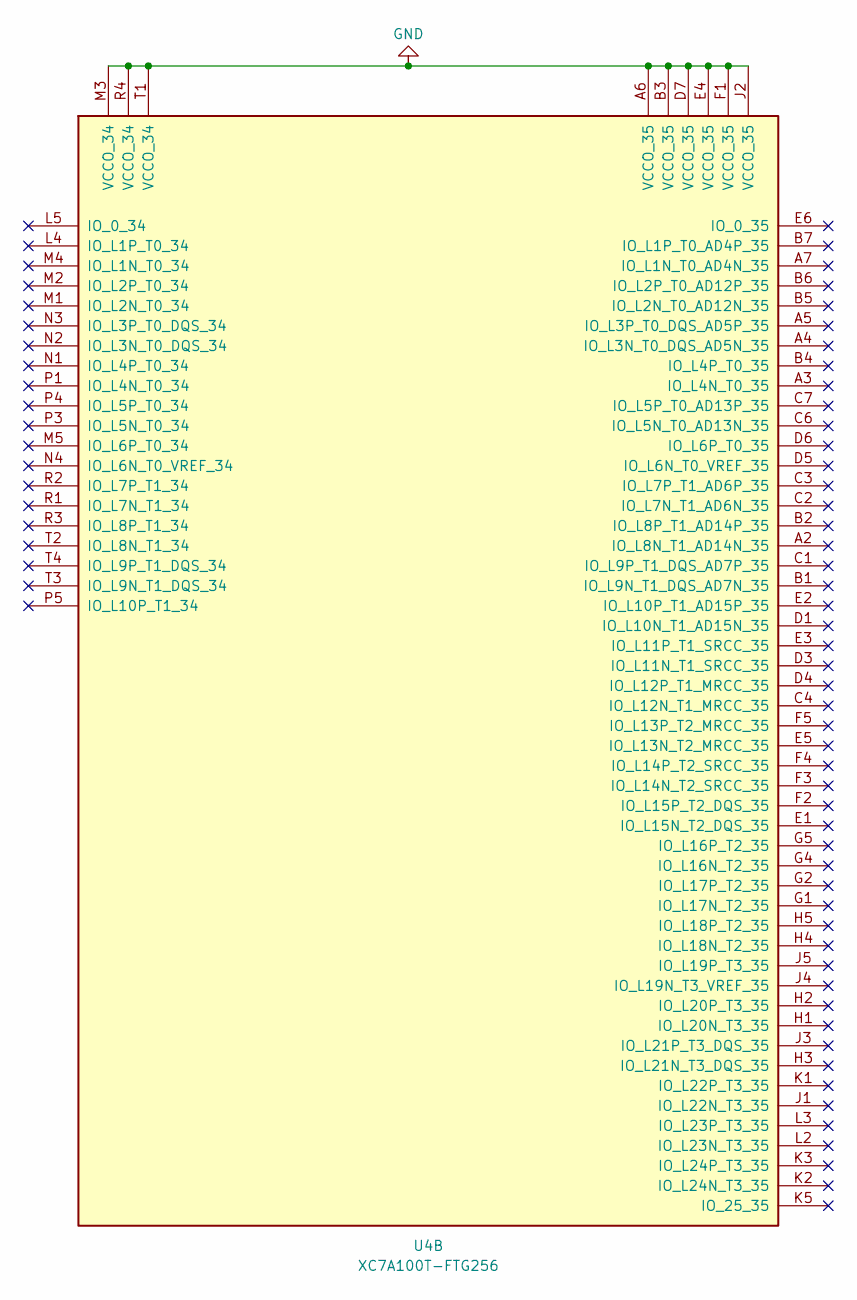
[picture p12: schematic FPGA2.kicad_sch, FPGA Unit B]

Parts:
U4: XC7A100T-FTG256; BGA256C100P16X16_1700X1700X155

Connections:
GND: U4.A6 (VCCO_35), U4.B3 (VCCO_35), U4.D7 (VCCO_35), U4.E4 (VCCO_35), U4.F1 (VCCO_35), U4.J2 (VCCO_35), U4.M3 (VCCO_34), U4.R4 (VCCO_34), U4.T1 (VCCO_34); also elsewhere on the board

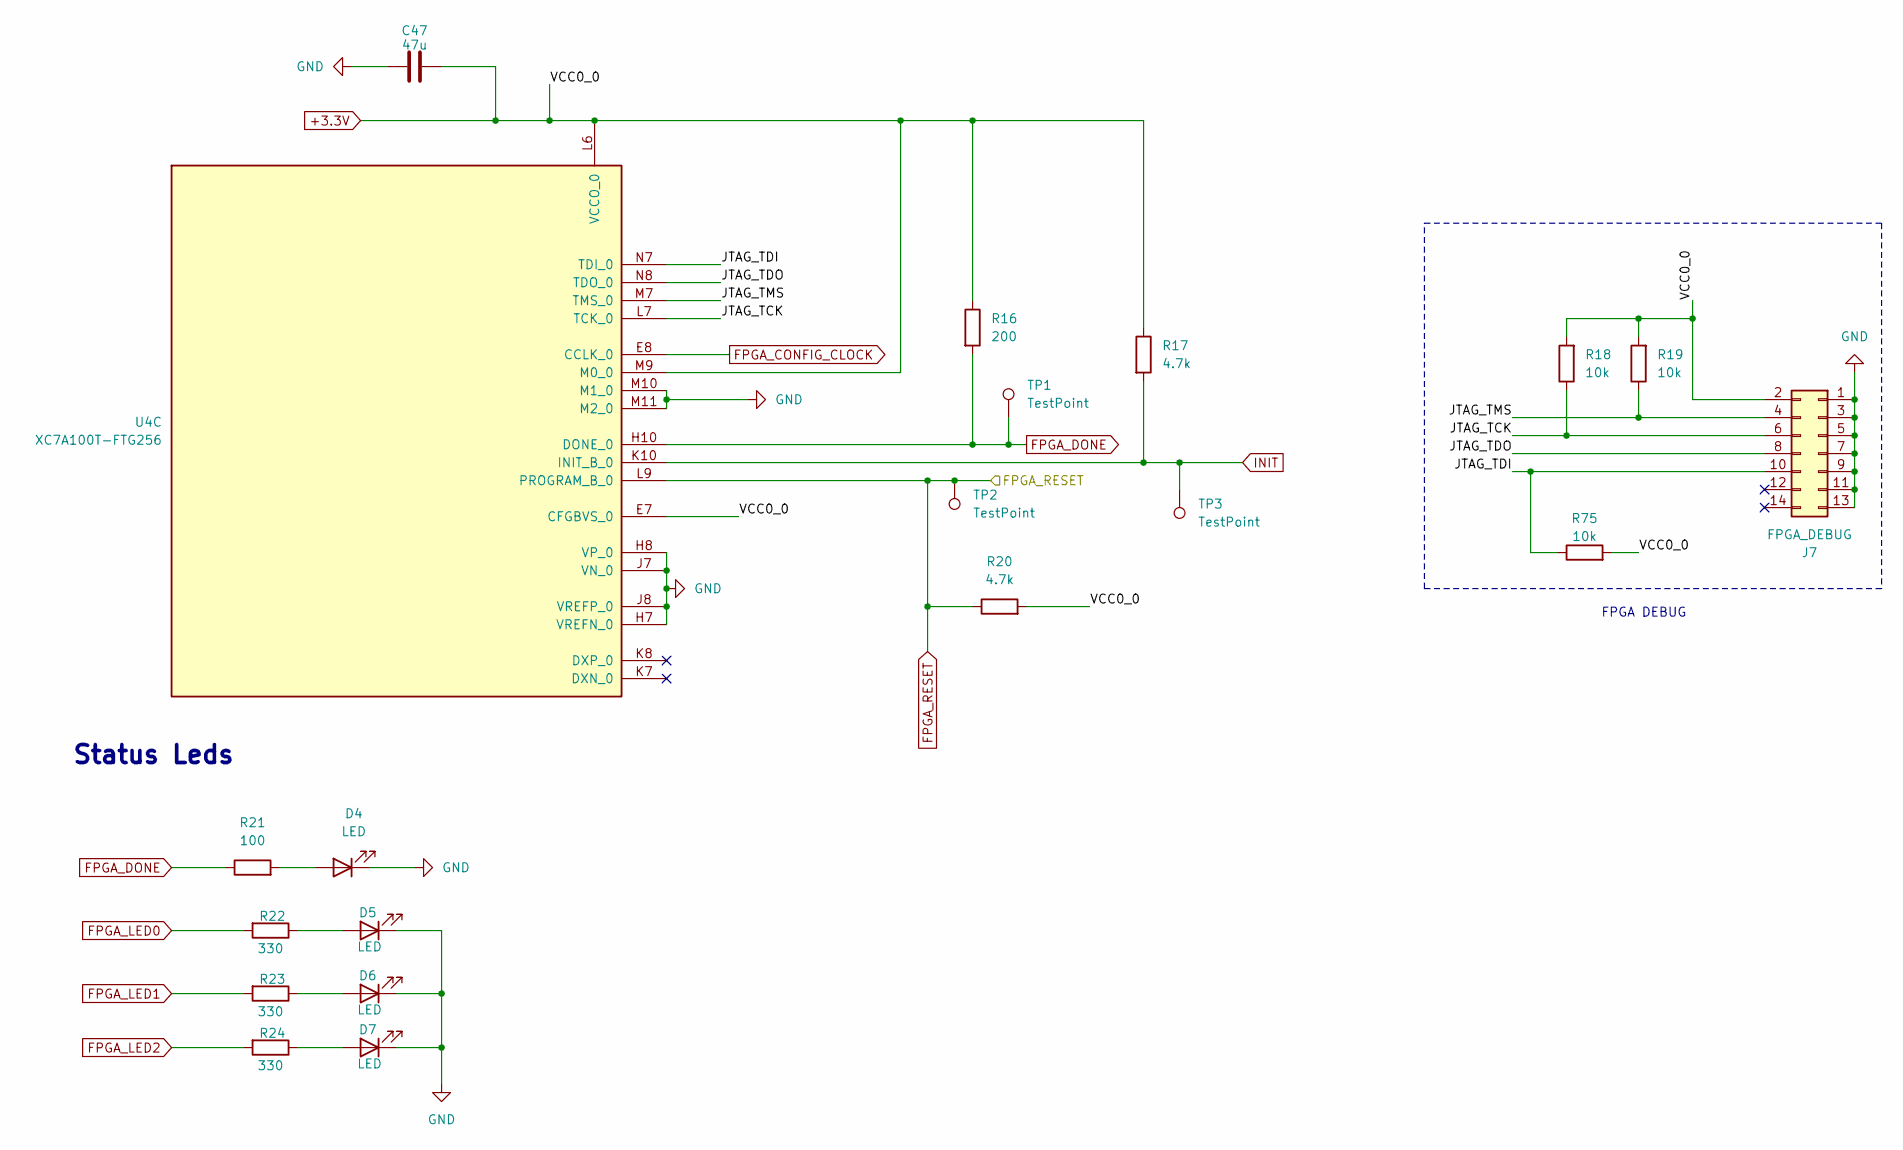
[picture p13: schematic FPGA3.kicad_sch, FPGA Config]

Parts:
C47: 47u; C_1210_3225Metric_Pad1.33x2.70mm_HandSolder
D4, D5, D6, D7: LED; LED_1206_3216Metric_Pad1.42x1.75mm_HandSolder
J7: FPGA_DEBUG; MOLEX_87832-1420
R16: 200; R_1206_3216Metric_Pad1.30x1.75mm_HandSolder
R17, R20: 4.7k; R_1206_3216Metric_Pad1.30x1.75mm_HandSolder
R18, R19, R75: 10k; R_1206_3216Metric_Pad1.30x1.75mm_HandSolder
R21: 100; R_1206_3216Metric_Pad1.30x1.75mm_HandSolder
R22, R23, R24: 330; R_1206_3216Metric_Pad1.30x1.75mm_HandSolder
TP1, TP2, TP3: TestPoint; TestPoint_Pad_D2.0mm
U4: XC7A100T-FTG256; BGA256C100P16X16_1700X1700X155

Connections:
+3.3V: C47.1, J7.2, R16.1, R17.1, R18.2, R19.2, R20.2, R75.2, U4.E7 (CFGBVS_0), U4.L6 (VCCO_0), U4.M9 (M0_0); also elsewhere on the board
/FPGA/FPGA Config/JTAG_TCK: J7.6, R18.1, U4.L7 (TCK_0)
/FPGA/FPGA Config/JTAG_TDI: J7.10, R75.1, U4.N7 (TDI_0)
/FPGA/FPGA Config/JTAG_TDO: J7.8, U4.N8 (TDO_0)
/FPGA/FPGA Config/JTAG_TMS: J7.4, R19.1, U4.M7 (TMS_0)
FPGA_CONFIG_CLOCK: U4.E8 (CCLK_0); also elsewhere on the board
FPGA_DONE: R16.2, R21.1, TP1.1, U4.H10 (DONE_0); also elsewhere on the board
FPGA_LED0: R22.2; also elsewhere on the board
FPGA_LED1: R23.2; also elsewhere on the board
FPGA_LED2: R24.2; also elsewhere on the board
FPGA_RESET: R20.1, TP2.1, U4.L9 (PROGRAM_B_0); also elsewhere on the board
GND: C47.2, D4.1 (K), D5.1 (K), D6.1 (K), D7.1 (K), J7.1, J7.3, J7.5, J7.7, J7.9, J7.11, J7.13, U4.H7 (VREFN_0), U4.H8 (VP_0), U4.J7 (VN_0), U4.J8 (VREFP_0), U4.M10 (M1_0), U4.M11 (M2_0); also elsewhere on the board
INIT: R17.2, TP3.1, U4.K10 (INIT_B_0)
unnamed: D4.2 (A), R21.2
unnamed: D5.2 (A), R22.1
unnamed: D6.2 (A), R23.1
unnamed: D7.2 (A), R24.1

Notes on the sheet:
FPGA DEBUG
Status Leds

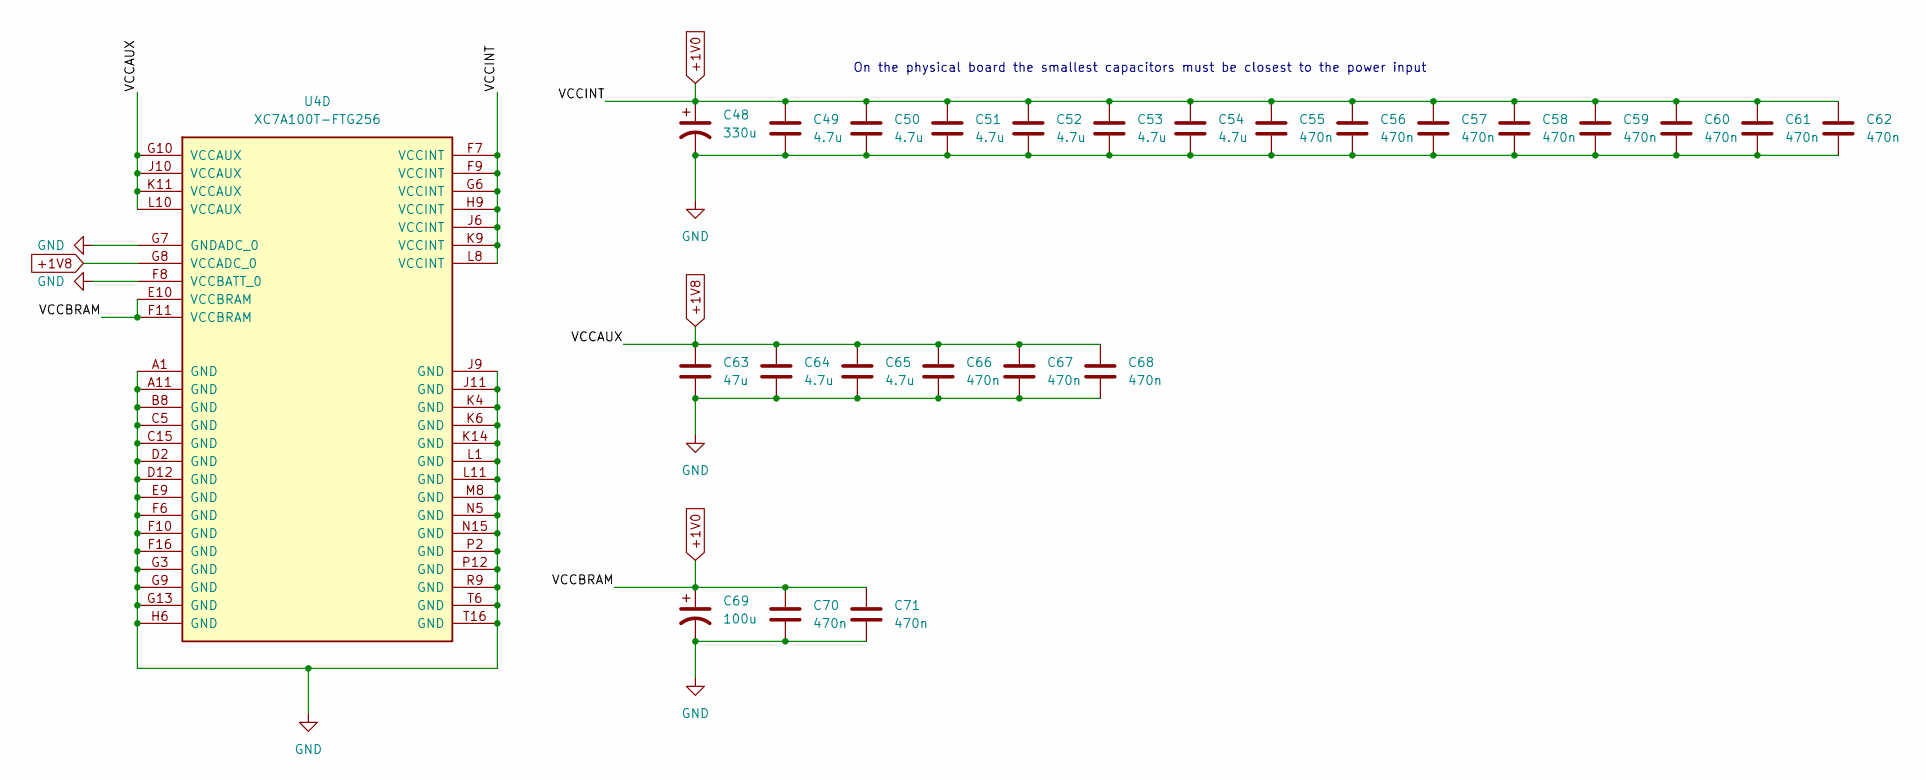
[picture p14: schematic FPGA4.kicad_sch, FPGA Power Supply]

Parts:
C48: 330u; CP_EIA-7343-31_Kemet-D_Pad2.25x2.55mm_HandSolder
C49, C50, C51, C52, C53, C54, C64, C65: 4.7u; C_0805_2012Metric_Pad1.18x1.45mm_HandSolder
C55, C56, C57, C58, C59, C60, C61, C62, C66, C67, C68, C70, C71: 470n; C_0603_1608Metric_Pad1.08x0.95mm_HandSolder
C63: 47u; C_1210_3225Metric_Pad1.33x2.70mm_HandSolder
C69: 100u; C_1210_3225Metric_Pad1.33x2.70mm_HandSolder
U4: XC7A100T-FTG256; BGA256C100P16X16_1700X1700X155

Connections:
+1V0: C48.1, C49.1, C50.1, C51.1, C52.1, C53.1, C54.1, C55.1, C56.1, C57.1, C58.1, C59.1, C60.1, C61.1, C62.1, C69.1, C70.1, C71.1, U4.E10 (VCCBRAM), U4.F7 (VCCINT), U4.F9 (VCCINT), U4.F11 (VCCBRAM), U4.G6 (VCCINT), U4.H9 (VCCINT), U4.J6 (VCCINT), U4.K9 (VCCINT), U4.L8 (VCCINT); also elsewhere on the board
+1V8: C63.1, C64.1, C65.1, C66.1, C67.1, C68.1, U4.G8 (VCCADC_0), U4.G10 (VCCAUX), U4.J10 (VCCAUX), U4.K11 (VCCAUX), U4.L10 (VCCAUX); also elsewhere on the board
GND: C48.2, C49.2, C50.2, C51.2, C52.2, C53.2, C54.2, C55.2, C56.2, C57.2, C58.2, C59.2, C60.2, C61.2, C62.2, C63.2, C64.2, C65.2, C66.2, C67.2, C68.2, C69.2, C70.2, C71.2, U4.A1 (GND), U4.A11 (GND), U4.B8 (GND), U4.C5 (GND), U4.C15 (GND), U4.D2 (GND), U4.D12 (GND), U4.E9 (GND), U4.F6 (GND), U4.F8 (VCCBATT_0), U4.F10 (GND), U4.F16 (GND), U4.G3 (GND), U4.G7 (GNDADC_0), U4.G9 (GND), U4.G13 (GND), U4.H6 (GND), U4.J9 (GND), U4.J11 (GND), U4.K4 (GND), U4.K6 (GND), U4.K14 (GND), U4.L1 (GND), U4.L11 (GND), U4.M8 (GND), U4.N5 (GND), U4.N15 (GND), U4.P2 (GND), U4.P12 (GND), U4.R9 (GND), U4.T6 (GND), U4.T16 (GND); also elsewhere on the board

Notes on the sheet:
On the physical board the smallest capacitors must be closest to the power input

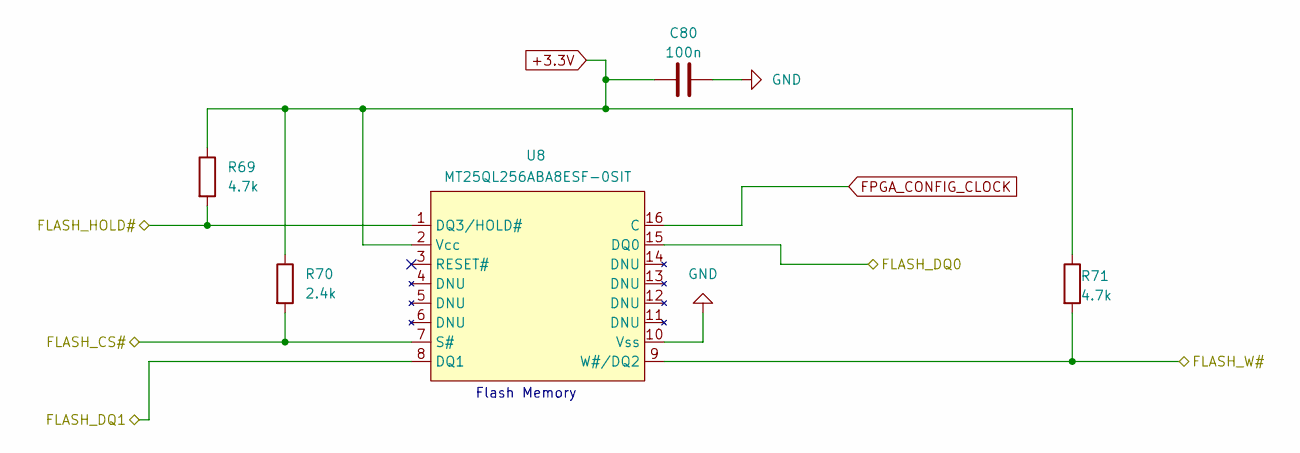
[picture p15: schematic FlashMem.kicad_sch, FPGA Flash Memory]

Parts:
C80: 100n; C_1206_3216Metric_Pad1.33x1.80mm_HandSolder
R69, R71: 4.7k; R_1206_3216Metric_Pad1.30x1.75mm_HandSolder
R70: 2.4k; R_1206_3216Metric_Pad1.30x1.75mm_HandSolder
U8: MT25QL256ABA8ESF-0SIT; SOIC127P1032X265-16N

Connections:
+3.3V: C80.1, R69.1, R70.1, R71.1, U8.2 (Vcc); also elsewhere on the board
/FPGA/Unit A/Flash Memory/FLASH_CS#: R70.2, U8.7 (S#); also elsewhere on the board
/FPGA/Unit A/Flash Memory/FLASH_DQ0: U8.15 (DQ0); also elsewhere on the board
/FPGA/Unit A/Flash Memory/FLASH_DQ1: U8.8 (DQ1); also elsewhere on the board
/FPGA/Unit A/Flash Memory/FLASH_HOLD#: R69.2, U8.1 (DQ3/HOLD#); also elsewhere on the board
/FPGA/Unit A/Flash Memory/FLASH_W#: R71.2, U8.9 (W#/DQ2); also elsewhere on the board
FPGA_CONFIG_CLOCK: U8.16 (C); also elsewhere on the board
GND: C80.2, U8.10 (Vss); also elsewhere on the board

Notes on the sheet:
Flash Memory

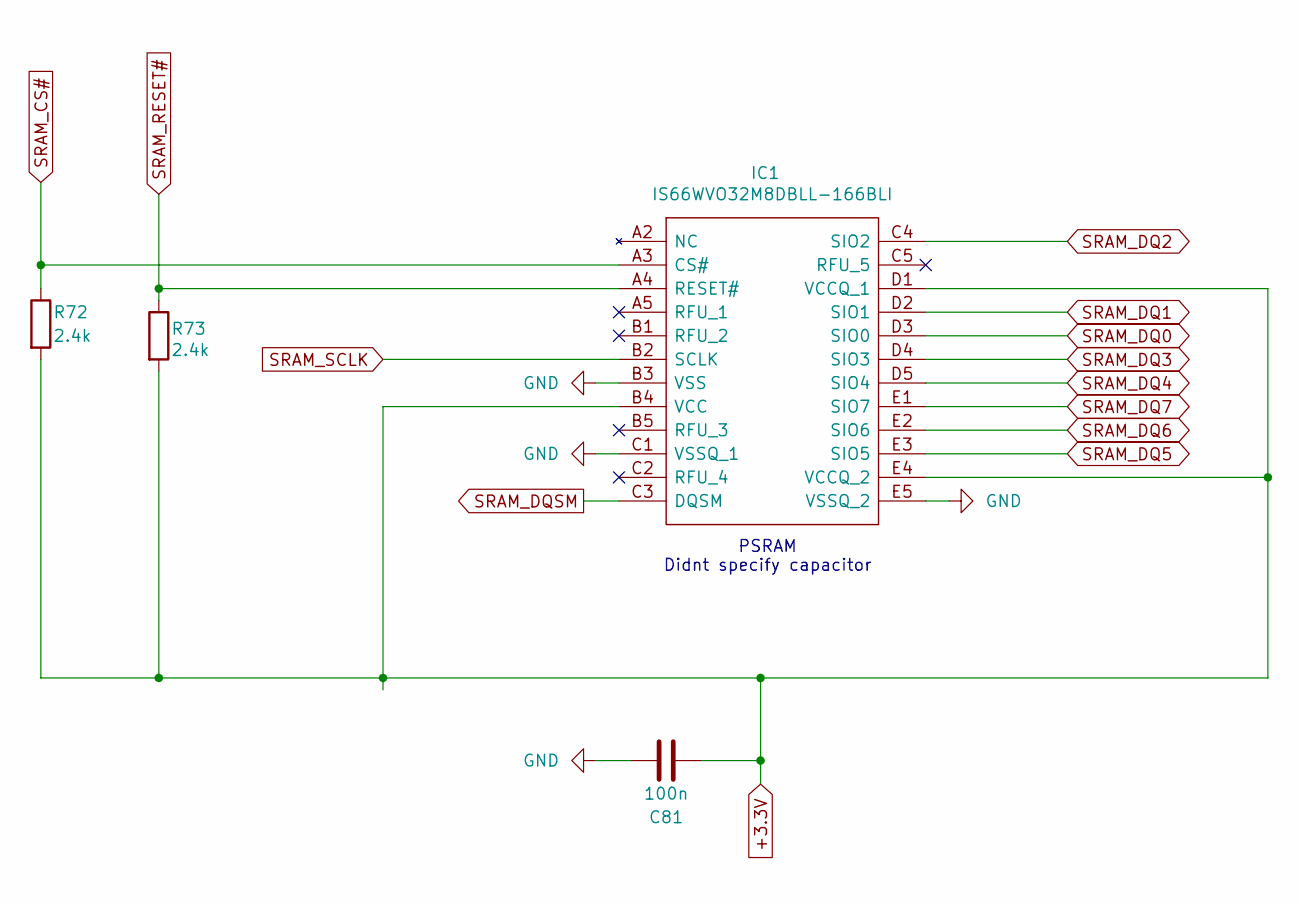
[picture p16: schematic SRAM.kicad_sch, FPGA SRAM]

Parts:
C81: 100n; C_1206_3216Metric_Pad1.33x1.80mm_HandSolder
IC1: IS66WVO32M8DBLL-166BLI; BGA24C100P5X5_600X800X120; Mouser Part Number 870-IS66W8DBLL166BLI
R72, R73: 2.4k; R_1206_3216Metric_Pad1.30x1.75mm_HandSolder

Connections:
+3.3V: C81.1, IC1.B4 (VCC), IC1.D1 (VCCQ_1), IC1.E4 (VCCQ_2), R72.2, R73.2; also elsewhere on the board
GND: C81.2, IC1.B3 (VSS), IC1.C1 (VSSQ_1), IC1.E5 (VSSQ_2); also elsewhere on the board
SRAM_CS#: IC1.A3 (CS#), R72.1; also elsewhere on the board
SRAM_DQ0: IC1.D3 (SIO0); also elsewhere on the board
SRAM_DQ1: IC1.D2 (SIO1); also elsewhere on the board
SRAM_DQ2: IC1.C4 (SIO2); also elsewhere on the board
SRAM_DQ3: IC1.D4 (SIO3); also elsewhere on the board
SRAM_DQ4: IC1.D5 (SIO4); also elsewhere on the board
SRAM_DQ5: IC1.E3 (SIO5); also elsewhere on the board
SRAM_DQ6: IC1.E2 (SIO6); also elsewhere on the board
SRAM_DQ7: IC1.E1 (SIO7); also elsewhere on the board
SRAM_DQSM: IC1.C3 (DQSM); also elsewhere on the board
SRAM_RESET#: IC1.A4 (RESET#), R73.1; also elsewhere on the board
SRAM_SCLK: IC1.B2 (SCLK); also elsewhere on the board

Notes on the sheet:
PSRAM
Didnt specify capacitor

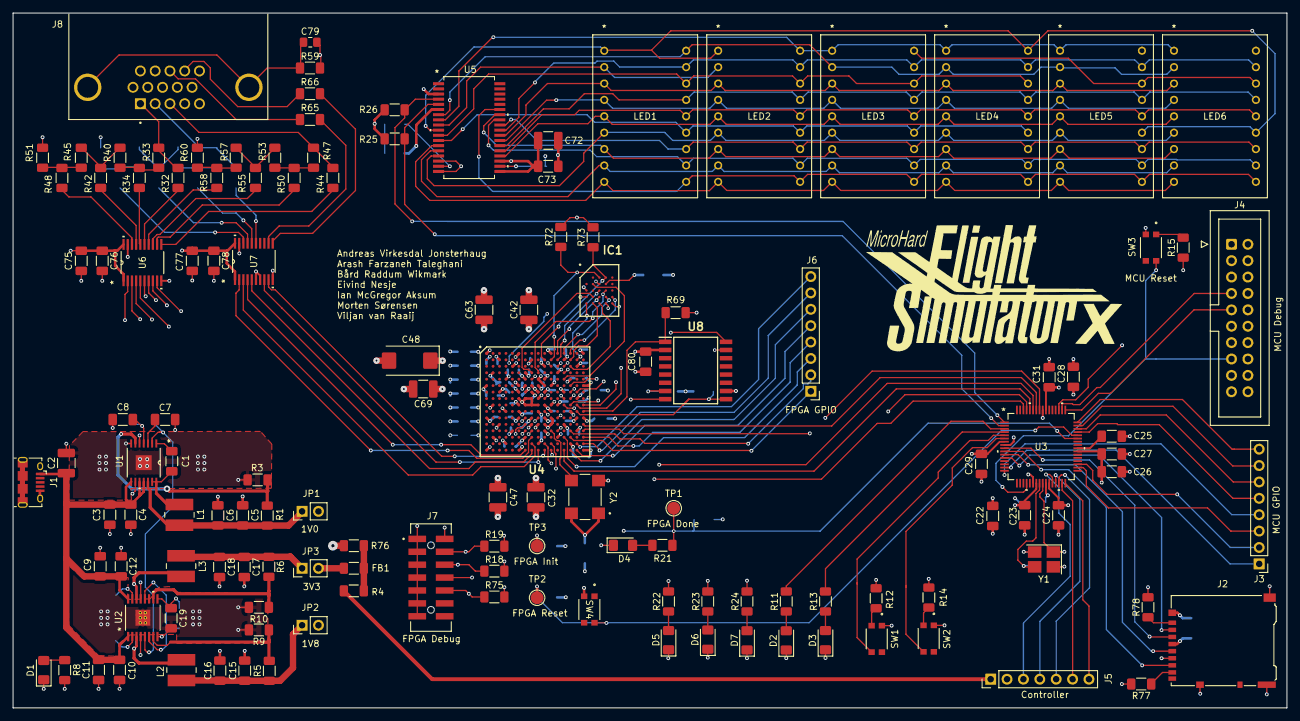
[picture p17: board MicroHard.kicad_pcb from above]

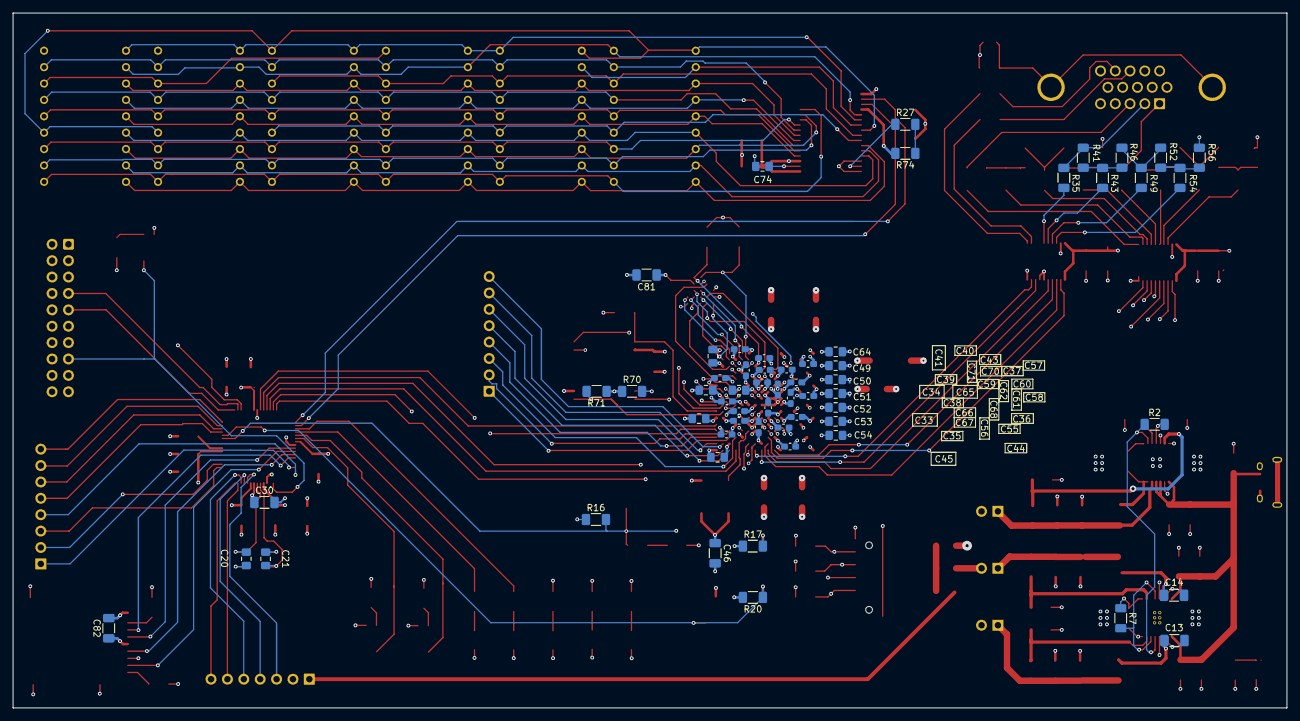
[picture p18: board MicroHard.kicad_pcb from below]

Board: 6 copper layers, 197.5 x 107.7 mm, 192 parts (59 on the bottom side), 175 nets.
