MH-Flight-Simulator-X/PCB/MicroHardController/MicroHardController.kicad_pcb

## KiCad design MicroHardController/MicroHardController.kicad_pcb (2024-09-27)

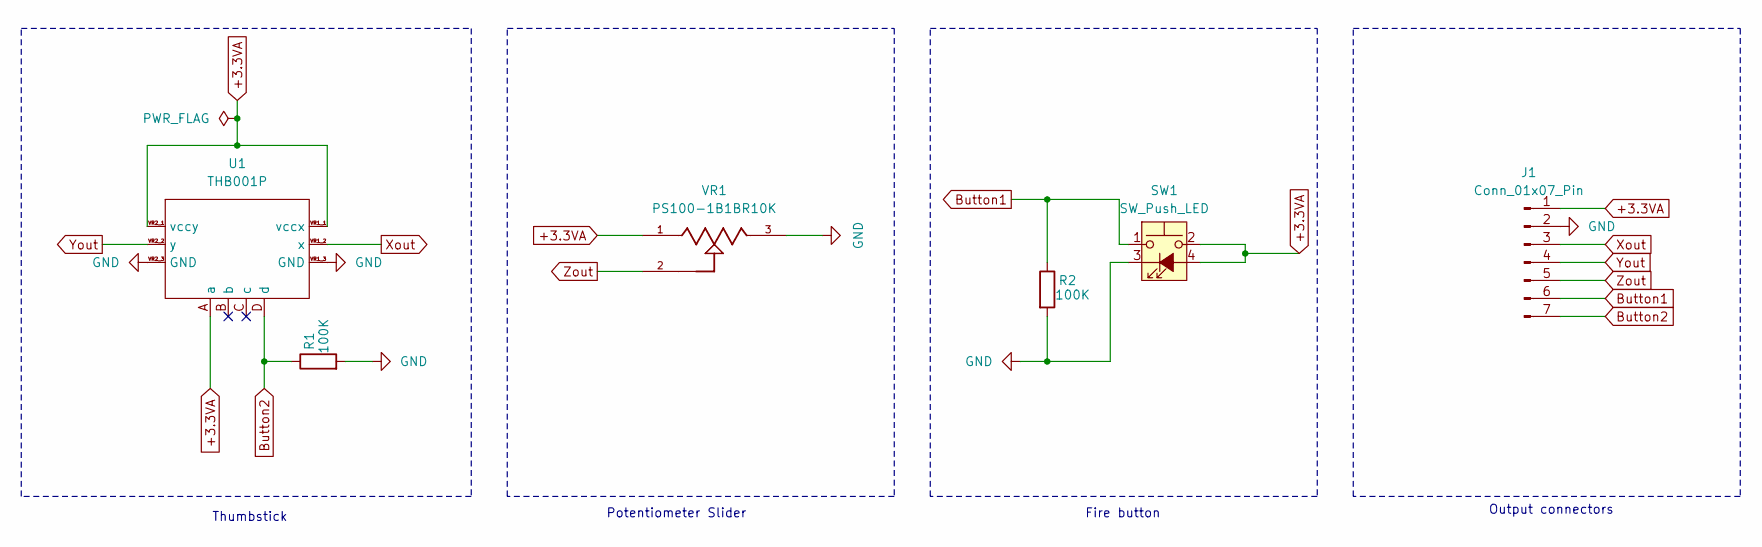
[picture p19: schematic MicroHardController.kicad_sch, MicroHard FlightSimulator Controller]

Parts:
J1: Conn_01x07_Pin; PinHeader_1x07_P2.54mm_Vertical
R1, R2: 100K; R_1206_3216Metric_Pad1.30x1.75mm_HandSolder
SW1: SW_Push_LED; PinHeader_1x04_P2.54mm_Vertical
U1: THB001P; CNK_THB001P
VR1: PS100-1B1BR10K; TRIM_PS100-1B1BR10K; PARTREV B

Connections:
+3.3VA: J1.1, SW1.2, SW1.4 (A), U1.A (a), U1.VR1_1 (vccx), U1.VR2_1 (vccy), VR1.1
Button1: J1.6, R2.1, SW1.1
Button2: J1.7, R1.1, U1.D (d)
GND: J1.2, R1.2, R2.2, SW1.3 (K), U1.VR1_3 (GND), U1.VR2_3 (GND), VR1.3
Xout: J1.3, U1.VR1_2 (x)
Yout: J1.4, U1.VR2_2 (y)
Zout: J1.5, VR1.2

Notes on the sheet:
Fire button
Thumbstick
Output connectors
Potentiometer Slider

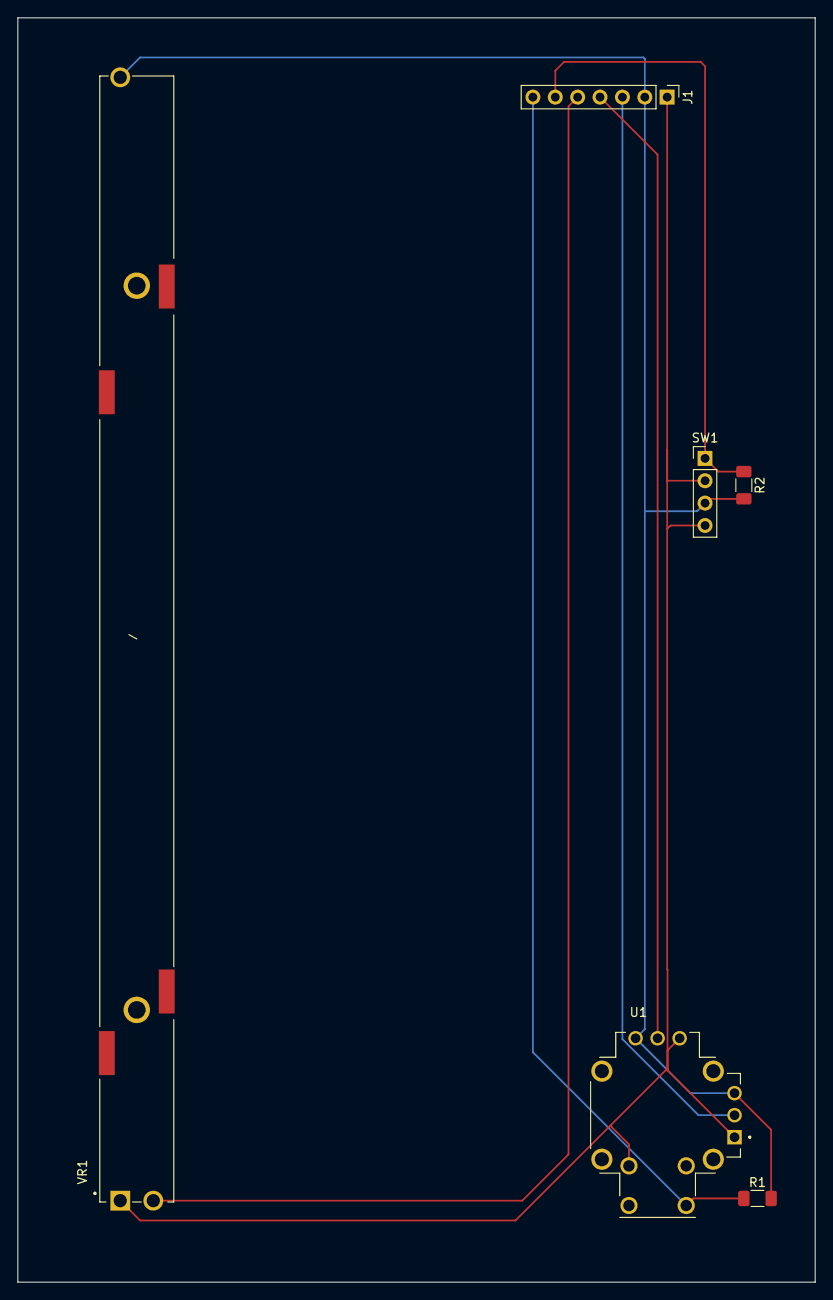
[picture p20: board MicroHardController.kicad_pcb from above]

Board: 2 copper layers, 90.5 x 143.5 mm, 6 parts (0 on the bottom side), 7 nets.
