MH-Flight-Simulator-X/PCB/(commit log)

2024-09-06 feat: powersupply started
    [MicroHard.kicad_pcb, PowerSupply.kicad_sch]
2024-09-07 feat: powersupply
    [PowerSupply.kicad_sch]
2024-09-07 feat: finished power supply
    [PowerSupply.kicad_sch]
2024-09-08 feat: added jumper
    [MicroHard.kicad_sch, MicroHardController.kicad_pcb, MicroHardController.kicad_sch]
2024-09-08 fix: powersupply passes ERV
    [MicroHard.kicad_sch, MicroHardController.kicad_sch, PowerSupply.kicad_sch]
2024-09-08 feat: microhard controller schematic
    [MicroHardController.kicad_sch]
2024-09-08 feat: controller pcb layout
    [MicroHardController.kicad_pcb, MicroHardController.kicad_sch]
2024-09-09 feat: added EFM32GG842... schematic symbol
    [MicroHardController.kicad_pcb]
2024-09-11 Add mcu symbol and footprint
    [MicroHard.kicad_pcb, MicroHard.kicad_sch, mcu.kicad_sch]
2024-09-17 feat: added fpga
    [FPGA3.kicad_sch, FPGA4.kicad_sch]
2024-09-19 extra files
    [FPGA3.kicad_sch, FPGA4.kicad_sch]
2024-09-22 feat: finished FPGA config
    [FPGA.kicad_sch, FPGA1.kicad_sch, FPGA3.kicad_sch, FPGA4.kicad_sch]
2024-09-23 feat: finished Flash mem and FPGA Config
    [FPGA.kicad_sch, FPGA1.kicad_sch, FPGA3.kicad_sch, FPGA4.kicad_sch]
2024-09-24 feat: finished config
    [CB3-3C-20M000000.step, FPGA.kicad_sch, FPGA1.kicad_sch, FPGA2.kicad_sch]
2024-09-24 MCU schematic
    [MicroHard.kicad_sch, display.kicad_sch, mcu.kicad_sch]
2024-09-24 feat: added VGA signal out from FPGA
    [FPGA.kicad_sch, FPGA1.kicad_sch, FPGA2.kicad_sch, FPGA3.kicad_sch, display.kicad_sch]
2024-09-24 feat: VGA out lines from FPGA drawn
    [FPGA.kicad_sch, FPGA1.kicad_sch, FPGA2.kicad_sch, FPGA3.kicad_sch, FPGA4.kicad_sch, MicroHard.kicad_sch, PowerSupply.kicad_sch, display.kicad_sch]
2024-09-25 feat: finished schematic, TODO: go through checklist
    [BGA256C100P16X16_1700X1700X155.PcbLib, EDI2CAP.CFG, FPGA.kicad_sch, FPGA1.kicad_sch, FPGA2.kicad_sch, FPGA3.kicad_sch, FPGA4.kicad_sch, XC7A100T-2FTG256C.SchLib]
2024-09-26 feat: completed schematic draft
    [87832-1420.step, FPGA.kicad_sch, FPGA1.kicad_sch, FPGA3.kicad_sch, FlashMem.kicad_sch, SRAM.kicad_sch]
2024-09-26 Finish display
    [MicroHard.kicad_sch, PowerSupply.kicad_sch, display.kicad_sch, mcu.kicad_sch]
2024-09-26 Renumber parts
    [FPGA.kicad_sch, FPGA1.kicad_sch, FPGA2.kicad_sch, FPGA3.kicad_sch, FPGA4.kicad_sch, FlashMem.kicad_sch, PowerSupply.kicad_sch, SRAM.kicad_sch]
2024-09-26 Add missing footprint libs
    [display.kicad_sch]
2024-09-26 fix: controller fix
    [MicroHardController.kicad_sch]
2024-09-26 Add Controller Btn 2 to MCU
    [mcu.kicad_sch]
2024-09-26 added VGA footprint
    [mcu.kicad_sch, vga_out_sch.kicad_sch]
2024-09-26 Small fixes
    [FPGA3.kicad_sch, MicroHard.kicad_pcb, PowerSupply.kicad_sch]
2024-09-27 Initial layout
    [FPGA1.kicad_sch, FPGA3.kicad_sch, FPGA4.kicad_sch, FlashMem.kicad_sch, MicroHard.kicad_pcb, PowerSupply.kicad_sch, SRAM.kicad_sch, display.kicad_sch]
2024-09-27 VGA and Display layout
    [FPGA1.kicad_sch, MicroHard.kicad_pcb, PowerSupply.kicad_sch, display.kicad_sch]
2024-09-27 feat: controller fixed
    [MicroHardController.kicad_pcb, MicroHardController.kicad_sch]
2024-09-27 power plane
    [FPGA2.kicad_sch, FPGA3.kicad_sch, MicroHard.kicad_pcb, mcu.kicad_sch]
2024-09-28 Power supply layout
    [MicroHard.kicad_pcb, PowerSupply.kicad_sch, mcu.kicad_sch]
2024-09-28 Add MCU
    [MicroHard.kicad_pcb]
2024-09-29 finished memory
    [MicroHard.kicad_pcb, vga_out_sch.kicad_sch]
2024-09-29 wired up VGA
    [MicroHard.kicad_pcb]
2024-09-30 finished FPGA
    [FPGA1.kicad_sch, MicroHard.kicad_pcb]
2024-09-30 finished layout
    [MicroHard.kicad_pcb]
2024-09-30 Clean up
    [MicroHard.kicad_pcb]
2024-09-30 Fix vias
    [MicroHard.kicad_pcb]
2024-09-30 final fix
    [MicroHard.kicad_pcb]
2024-10-01 Final changes
    [MicroHard.kicad_pcb, mcu.kicad_sch]
2024-10-01 Change inductor footprint
    [MicroHard.kicad_pcb, PowerSupply.kicad_sch]
2024-10-01 Fix wrong display pin connection
    [MicroHard.kicad_pcb, display.kicad_sch]
2024-10-01 Add connector labels to silkscreen
    [MicroHard.kicad_pcb]
2024-11-20 Fix schematics for delivery
    [FPGA.kicad_sch, FPGA1.kicad_sch, FPGA2.kicad_sch, FPGA3.kicad_sch, FPGA4.kicad_sch, FlashMem.kicad_sch, MicroHard.kicad_pcb, MicroHard.kicad_sch]
2024-11-20 feat: added controller case SCAD files
    [joystick.scad, joystick_based.scad, original.scad]
